kirkholt/freETarget/Documentation/Pictures/Illustrations/Pistol Assembly 1.png

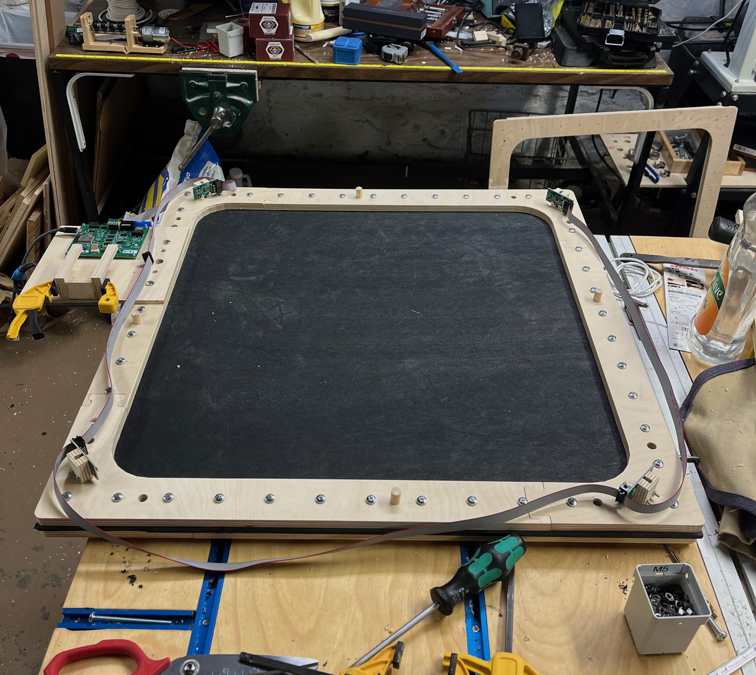
Documentation/Pictures/Illustrations/Pistol Assembly 1.png
