kirkholt/freETarget/Documentation/Pictures/Schematic.png

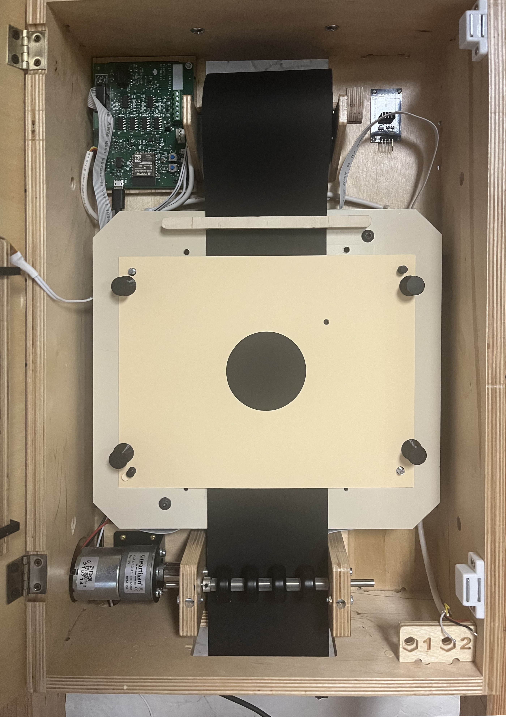
Documentation/Pictures/Schematic.png
