kirkholt/freETarget/Software/ESP32/test_scripts.txt

//
// WIFI Tests 
//
Static IP  { "WIFI_SSID": "googlefiber",  "WIFI_PWD": "kansas6108", "NAME_ID": 100, "NAME_TEXT":"ENGINEERING", "WIFI_IP":"192.168.86.109" }
Static IP  { "WIFI_SSID": "googlefiber",  "WIFI_PWD": "kansas6108", "NAME_ID": 100, "NAME_TEXT":"NEXUS", "WIFI_IP":"192.168.86.109" }
Static IP  { "WIFI_SSID": "googlefiber",  "WIFI_PWD": "kansas6108", "NAME_ID": 100, "NAME_TEXT":"62I", "WIFI_IP":"192.168.86.111" }
Static IP  { "WIFI_SSID": "COMET", "WIFI_IP":"192.168.0.103", "WIFI_GATEWAY":"192.168.0.1" }
Default IP { "WIFI_SSID": "", "WIFI_IP":"192.168.0.103", "WIFI_GATEWAY":"192.168.0.1" }
Dynamic IP { "WIFI_SSID": "googlefiber",  "WIFI_PWD": "kansas6108", "NAME_ID": 100, "NAME_TEXT":"ENGINEERING"}
{ "NAME_ID": 99, "NAME_TEXT":"ALLAN"}
{ "NAME_ID": 101}
HTTP Trace             {"TRACE":128}
Reset the target       {"RESET":0}
Reinitialize the board {"INIT":0}

{ "WIFI_SSID": "",  "WIFI_PWD": "", "NAME_ID": 4}

//
// Witness Paper Settings 
//
Practice witness paper { "PAPER_TIME":250, "PAPER_ECO":30, "PAPER_SHOT":4}
Practice witness paper { "PAPER_TIME":250, "PAPER_ECO":40, "PAPER_SHOT":2}
Practice witness paper { "PAPER_TIME":125, "PAPER_ECO":40, "PAPER_SHOT":4}

{ "AUTH_CODE":1234,  "AUTH_CODE":4321}
{ "AUTH_CODE":1234, "AUTH_CODE":0, "ECHO":0 }
{"WIFI_SSID":"FSixC! Box FE":, "WIFI_PWD":":1234512345123451234512345"}

Firmware debug trace   { "TRACE":16, "TRACE":32, "TRACE":64, "TEST":142}
Calculation debug trace {"TRACE": 2048, "TRACE":8, "TRACE":64}
Rapid Fire {"TRACE":2048}
Turn on RS488 {"AUX_MODE":8}

//
// Rapid Fire and Tabata 
//
Output for Rapid Fire  { "MFS_HOLD_C":18, "MFS_HOLD_D":20, "MFS_SELECT_CD":24}
LED control { "MFS_HOLD_C":18, "MFS_HOLD_D":20, "MFS_SELECT_CD":24}
ISSF 50m Rapid Fire       Five shots into a single target            {"TRACE":2048, "EVENT":"RFP Allan", "RAPID_COUNT":5,  "RAPID_TIME":8,   "RAPID_WAIT":5, "RAPID_ENABLE":0}
ISSF 50m Rapid Fire       Five shots into a single target            {"TRACE":2048,  "EVENT":"RFP Allan", "RAPID_COUNT": 1 , "RAPID_WAIT":3, "RAPID_TIME":8, "RAPID_ENABLE": 1 }
ISSF 50m Rapid Fire       No Trace                                   {"TRACE":2048, "EVENT":"RFP Allan", "RAPID_COUNT": 1 , "RAPID_WAIT":3, "RAPID_TIME":8, "RAPID_ENABLE": 1 }
ISSF 50m Rapid Fire       Five shots into a single target            {"TRACE":2048, "EVENT":"Rapid Fire 8S",      "RAPID_COUNT":5,  "RAPID_TIME":8,   "RAPID_WAIT":5, "RAPID_ENABLE":1}ISSF 25m Standard Pistol  Five shots into a single target           
 {"RAPID_REPEAT":5} 
 {"TRACE":2048, "EVENT":"Rapid Fire 30s",     "RAPID_COUNT":5,  "RAPID_TIME":30,  "RAPID_WAIT":5, "RAPID_ENABLE":1}
 
 {"TRACE":2048, "EVENT":"Rapid Fire 8S", "RAPID_COUNT":5, "RAPID_WAIT":7, "RAPID_TIME":50, "RAPID_ENABLE": 1 }

NRA Sport Pistol ON         One shot into a single target, repeat 5x {"TRACE":2048, "EVENT":"SPP Allan", "RAPID_COUNT":1,  "RAPID_TIME":3,   "RAPID_WAIT":7, "RAPID_ENABLE":1}
                                                                     {"TRACE":2120, "EVENT":"SPP Allan", "RAPID_COUNT":1,  "RAPID_TIME":3,   "RAPID_WAIT":7, "RAPID_ENABLE":1}
NRA Sport Pistol OFF        One shot into a single target, repeat 5x {"TRACE":2048, "EVENT":"SPP Betty", "RAPID_COUNT":1,  "RAPID_TIME":3,   "RAPID_WAIT":7, "RAPID_ENABLE":0}
NRA Sport Pistol ON         One shot into a single target, repeat 5x {"RAPID_COUNT":1,  "RAPID_TIME":3,   "RAPID_WAIT":7, "RAPID_ENABLE":1}

Tabata                      Tabata timing                            {"TRACE":2048, "EVENT":"Tabata",  "RAPID_COUNT": 1 , "RAPID_WAIT":3, "RAPID_TIME":7, "RAPID_ENABLE": 1 }
Done {"RAPID_ENABLE":0}

Turn Tabata on by switch   {"MFS_TAP_1":6}

//
// MFS Operation
//
PC Shot Test {"MFS_TAP_1":4 }
{"}
Start a download {"DOWNLOAD":1234567}
RS485 {"AUX_MODE":8}

{"ECHO":0}

//
// Calibration Tests 
//
Raw
{"CAL":1, "CAL":8, [-55.24, -61.51, 18.04, 78.51, -35.96, -43.34, -12.31, -35.85, 25.12, 40.27, -17.49, 32.01, -16.46, -29.50, 15.00, -65.67, -52.11, 22.98, -21.67, -16.85, 35.60, -41.26, 29.78, -24.88, 30.48, 91.39, -51.31, -0.62, -26.73, 21.00, -55.49, 10.10, 29.73, 14.96,  22.81, -23.55, -41.35, -7.55]}

Target Scan
{"CAL":2}
1
"1","1","7.7","-21.03","-15.66"
"2","1","6.9","-15.21","-28.20"
"3","1","6.5","-11.33","-33.89"
"4","1","6.4","-17.67","32.17"
"5","1","6.3","30.30","-21.61"
"6","1","4.9","23.84","42.26"
"7","1","4.3","36.51","-38.42"
"8","1","4.1","-34.60","-42.56"
"9","1","3.9","-51.80","22.48"
"10","1","3.0","16.47","-61.17"
"11","2","9.8","-0.24","-9.43"
"12","2","7.8","-8.49","-23.85"
"13","2","7.1","22.33","-20.86"
"14","2","6.8","28.63","17.05"
"15","2","6.6","-26.95","21.98"
"16","2","5.8","-41.04","-6.76"
"17","2","4.6","-50.76","0.22"
"18","2","3.9","-55.14","10.89"
"19","2","0.0","19.04","78.51"
"20","2","0.0","-56.24","-61.51"
!

Table Data
{"CAL":2}
2
-21.03, -15.66, -15.21, -28.20, -11.33, -33.89, -17.67, 32.17, 30.30, -21.61, 23.84, 42.26, 36.51, -38.42, -34.60, -42.56, -51.80, 22.48, 16.47, -61.17, -0.24, -9.43, -8.49, -23.85, 22.33, -20.86, 28.63, 17.05, -26.95, 21.98, -41.04, -6.76, -50.76, 0.22, -55.14, 10.89!

Commit Calibration {"CAL":3}

Show Calibration {"CAL":4}

void Calibration {"CAL":5}

ESPEFUSE

>ESPEFUSE adc_info --port COM3 --baud 115200
