kirkholt/freETarget/Documentation/Pictures/DC Motor Connection.png

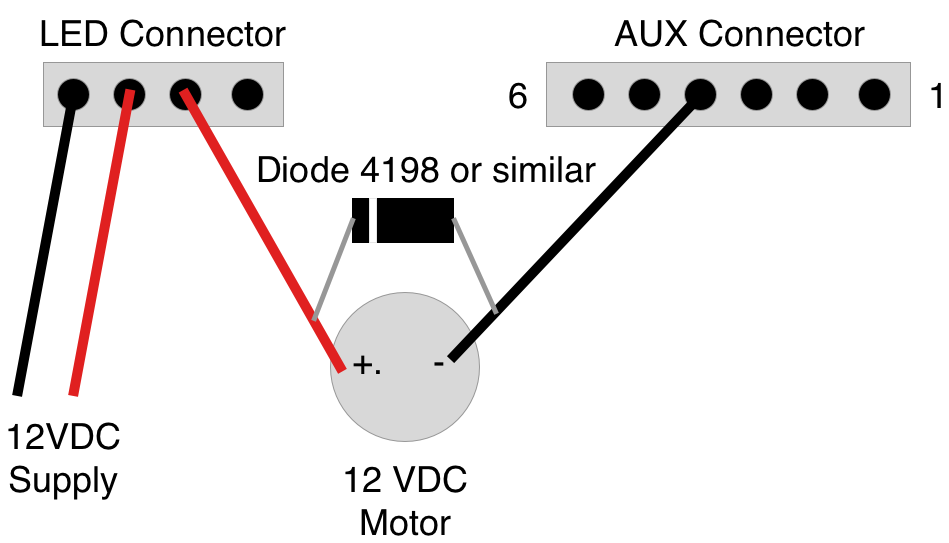
Documentation/Pictures/DC Motor Connection.png
