kirkholt/freETarget/Documentation/Pictures/Illustrations/50m Target Section.png

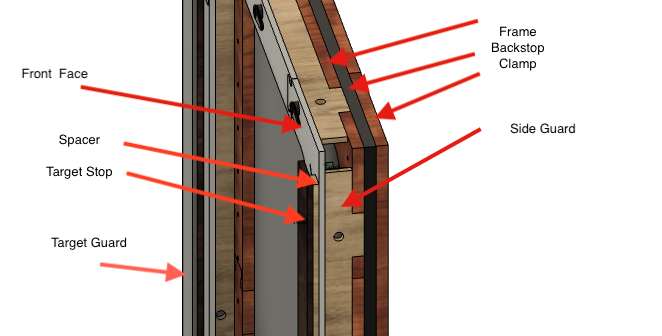
Documentation/Pictures/Illustrations/50m Target Section.png
