kirkholt/freETarget/Documentation/Pictures/Illustrations/Application Configuration.png

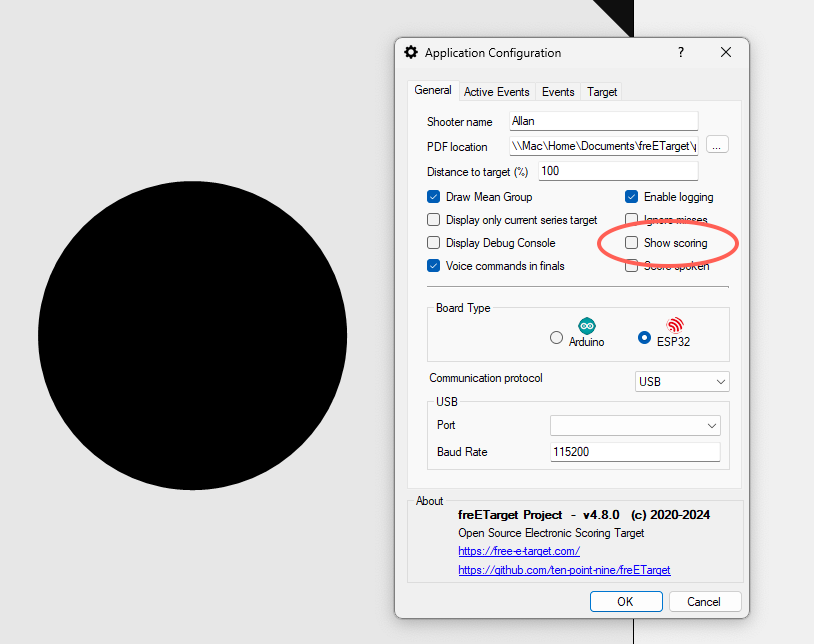
Documentation/Pictures/Illustrations/Application Configuration.png
