kirkholt/freETarget/Documentation/Pictures/Illustrations/Ethernet Cable V5 Harness.png

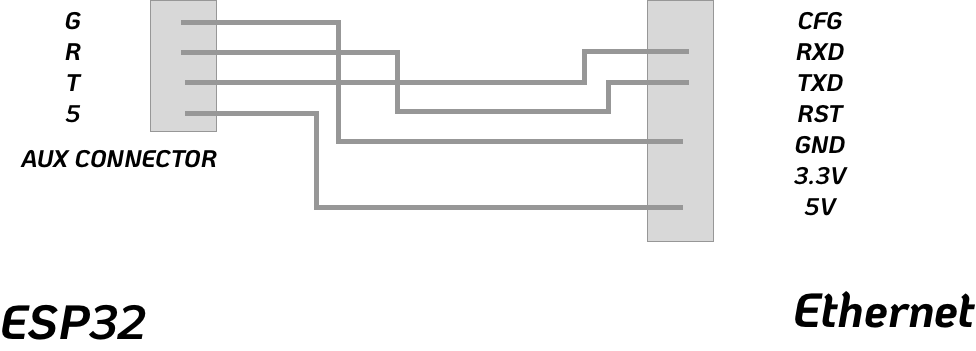
Documentation/Pictures/Illustrations/Ethernet Cable V5 Harness.png
