kirkholt/freETarget/Documentation/Pictures/Illustrations/Flat Cable.png

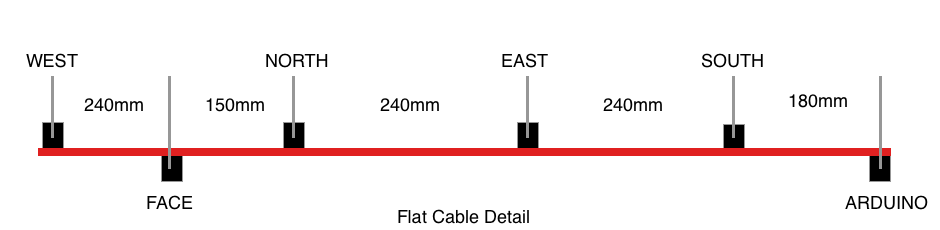
Documentation/Pictures/Illustrations/Flat Cable.png
