kirkholt/freETarget/Documentation/Pictures/Illustrations/freETarget Layout.png

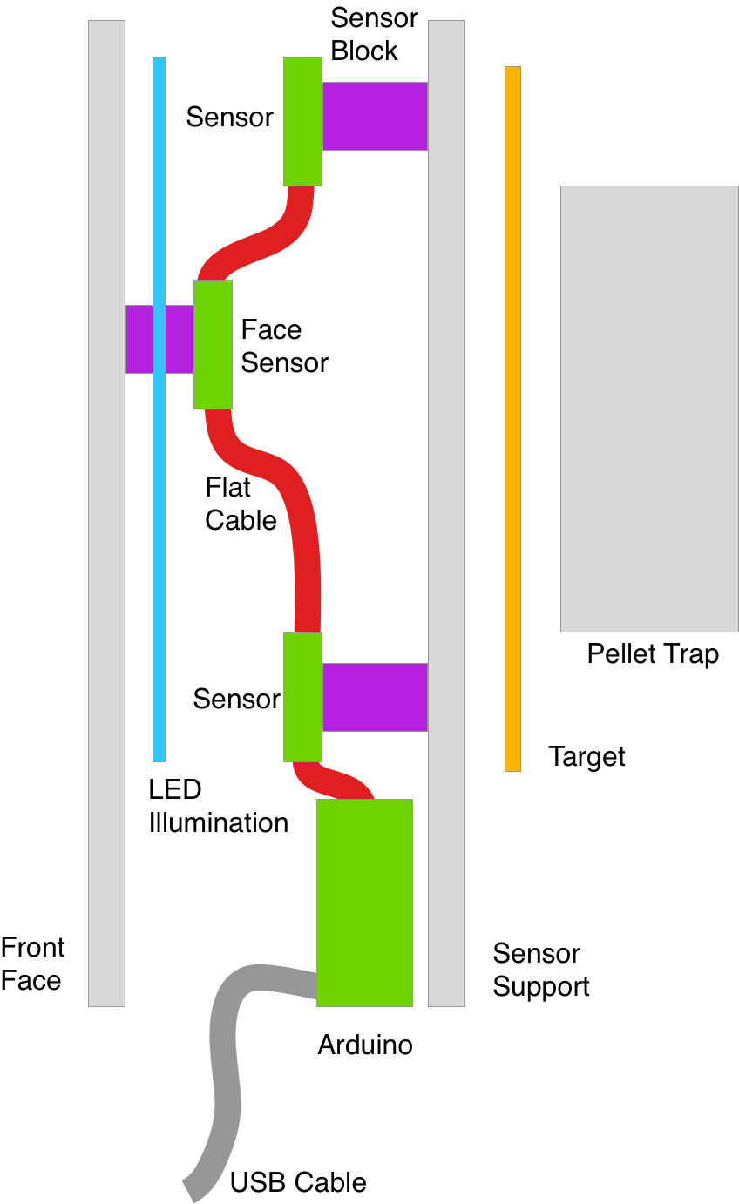
Documentation/Pictures/Illustrations/freETarget Layout.png
