kirkholt/freETarget/Documentation/Pictures/Illustrations/Front View.png

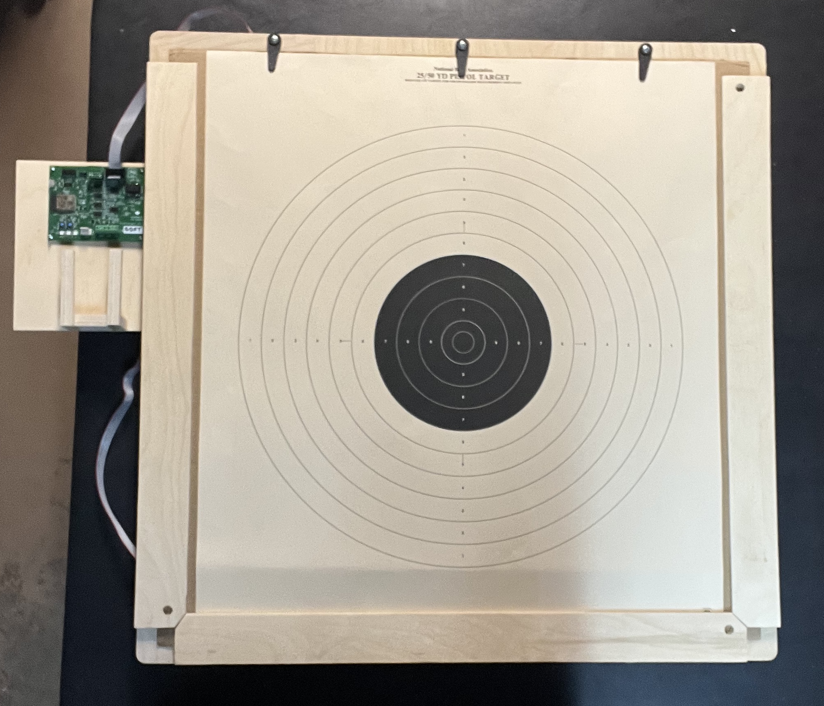
Documentation/Pictures/Illustrations/Front View.png
