kirkholt/freETarget/Documentation/Pictures/Illustrations/LiveTarget.png

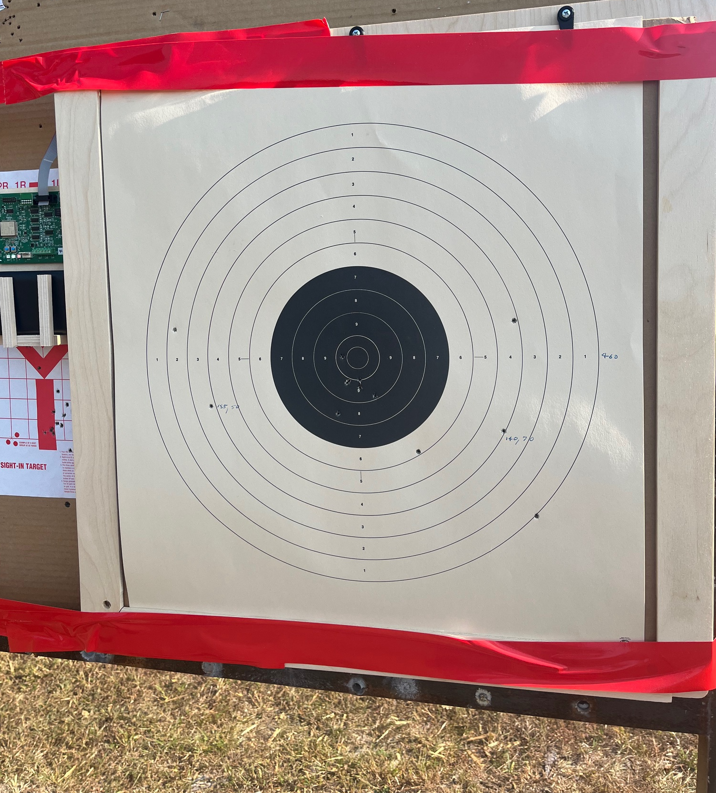
Documentation/Pictures/Illustrations/LiveTarget.png
