kirkholt/freETarget/Documentation/Pictures/Illustrations/PC Client.png

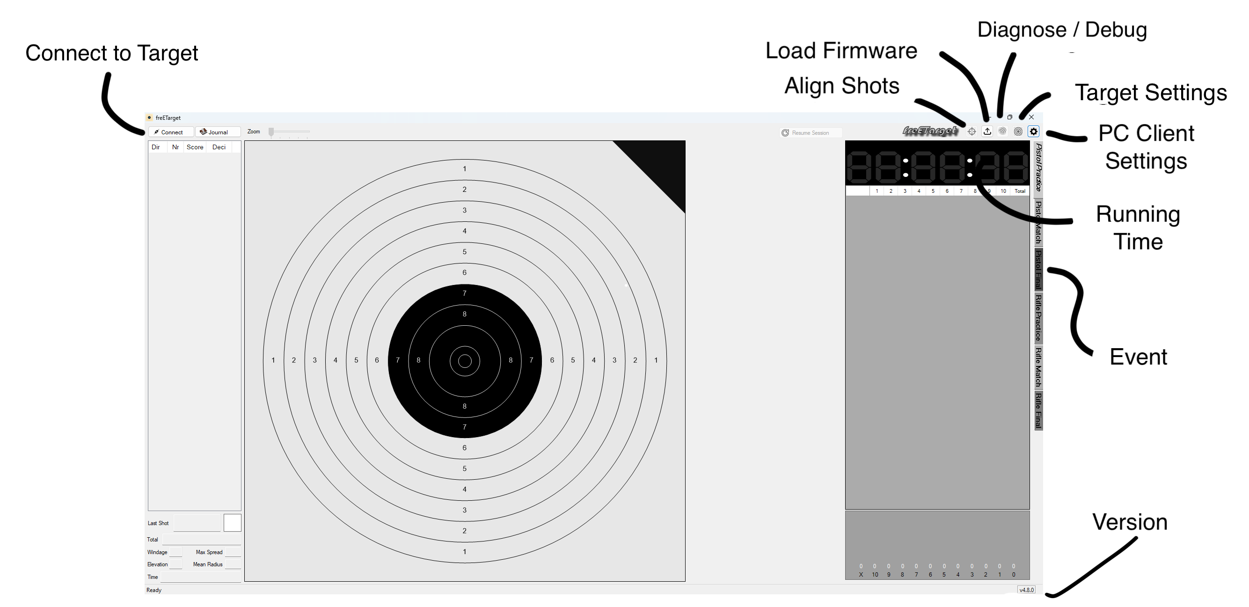
Documentation/Pictures/Illustrations/PC Client.png
