kirkholt/freETarget/Documentation/Pictures/Illustrations/Shelves.png

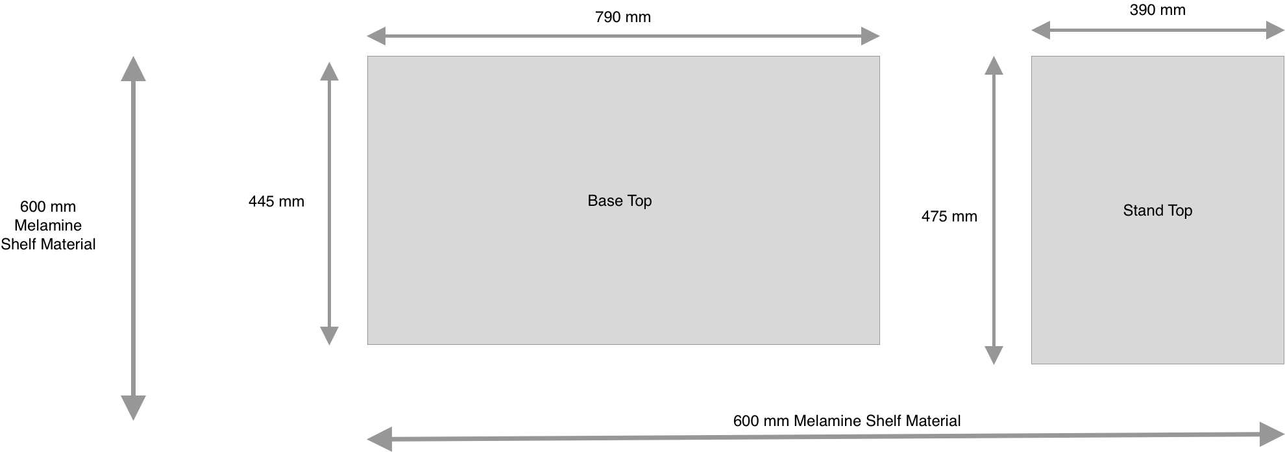
Documentation/Pictures/Illustrations/Shelves.png
