kirkholt/freETarget/Documentation/Pictures/Illustrations/USB Extender.png

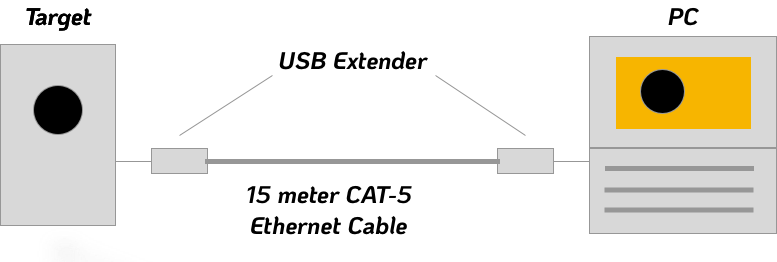
Documentation/Pictures/Illustrations/USB Extender.png
