kirkholt/freETarget/Documentation/Pictures/scope traces/SDS00013.bmp

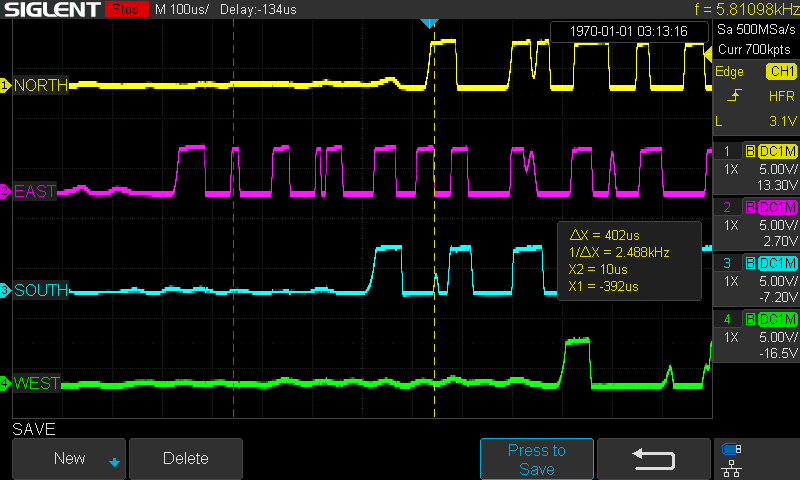
Documentation/Pictures/scope traces/SDS00013.bmp
