kirkholt/freETarget/Documentation/Pictures/scope traces/SDS00014.bmp

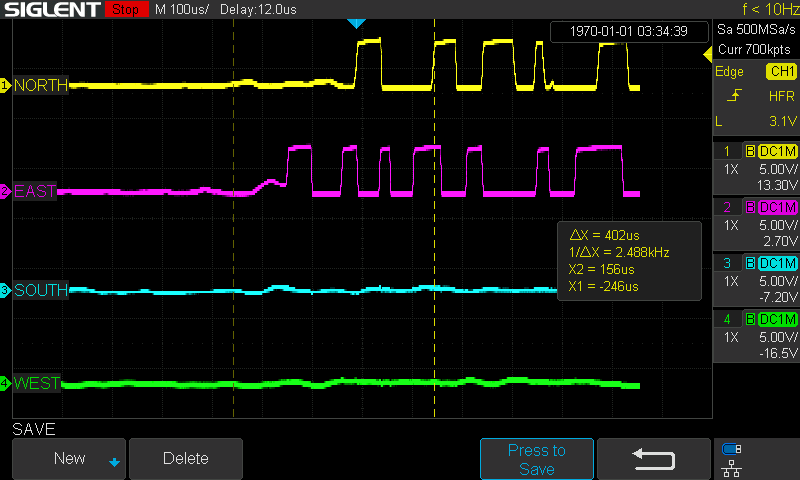
Documentation/Pictures/scope traces/SDS00014.bmp
