kirkholt/freETarget/Documentation/Pictures/scope traces/SDS00016.bmp

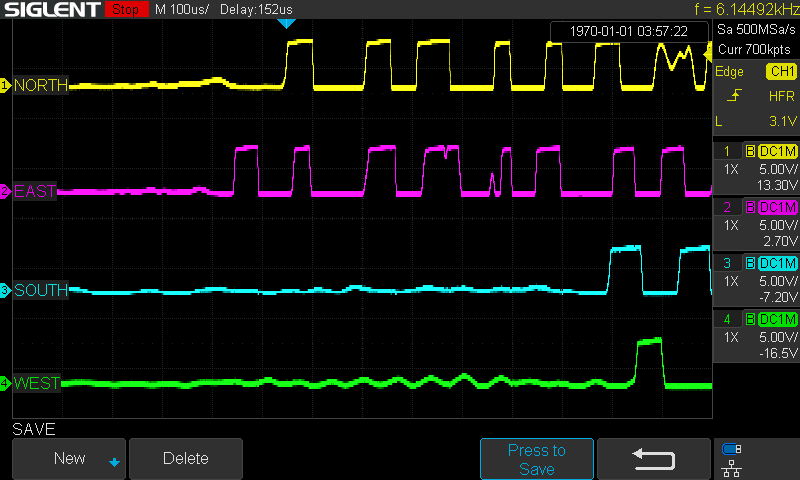
Documentation/Pictures/scope traces/SDS00016.bmp
