kirkholt/freETarget/Mechanical/CNC/Metal - Plastic/Witness Paper Complete.stl

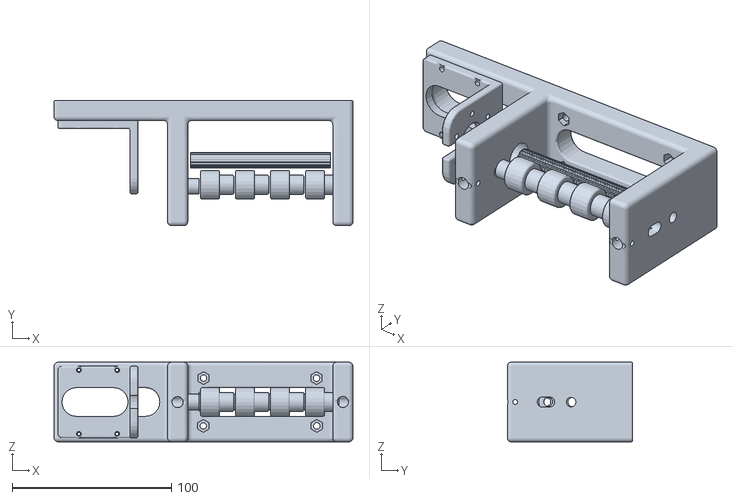
[picture p58: CAD file, 2026-10-04]
Mechanical/CNC/Metal - Plastic/Witness Paper Complete.stl
187.7 x 78.7 x 50.0
