kirkholt/freETarget/Mechanical/CNC/50m Pistol/50m Pistol.stl

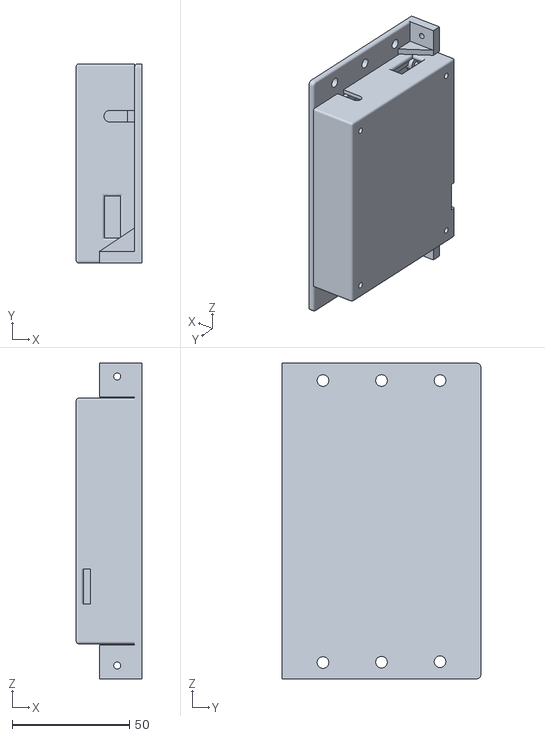
[picture p59: CAD file, 2026-10-04]
Mechanical/CNC/50m Pistol/50m Pistol.stl
28.0 x 85.0 x 135.0
