kirkholt/freETarget/Mechanical/CNC/Metal - Plastic/Magnetic Rifle Target.stl

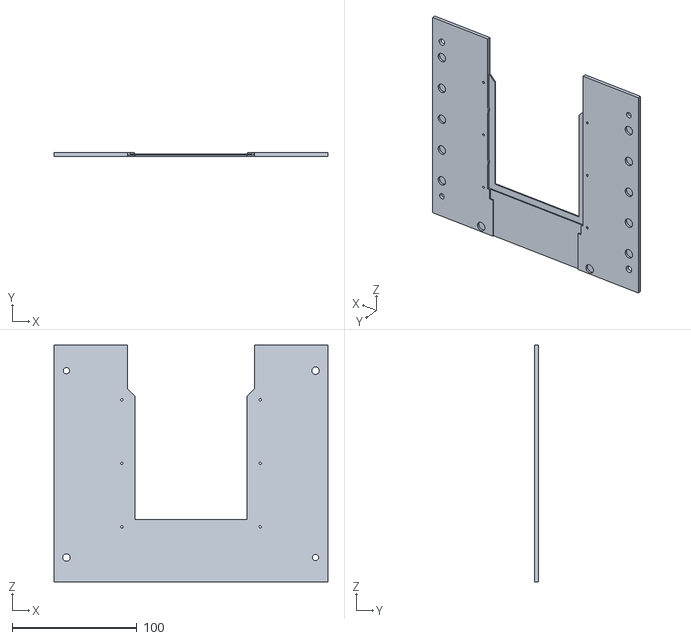
[picture p60: CAD file, 2026-10-04]
Mechanical/CNC/Metal - Plastic/Magnetic Rifle Target.stl
220.0 x 3.00 x 190.0
