kirkholt/freETarget/Mechanical/CNC/Piece Parts/Cable Guide/Laser Cable Guide.dxf

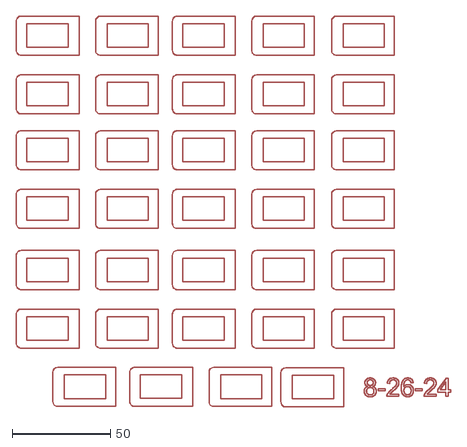
[picture p61: CAD file, 2026-10-04]
Mechanical/CNC/Piece Parts/Cable Guide/Laser Cable Guide.dxf
221.5 x 199.3
