kirkholt/freETarget/Mechanical/CNC/Piece Parts/Pellet Trap Guide.3mf

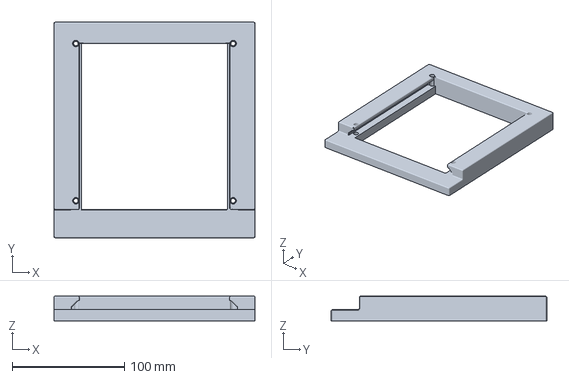
[picture p62: CAD file, 2026-10-04]
Mechanical/CNC/Piece Parts/Pellet Trap Guide.3mf
179.0 x 192.0 x 22.0 mm
