kirkholt/freETarget/Mechanical/CNC/Traffic Lights/Roll.stl

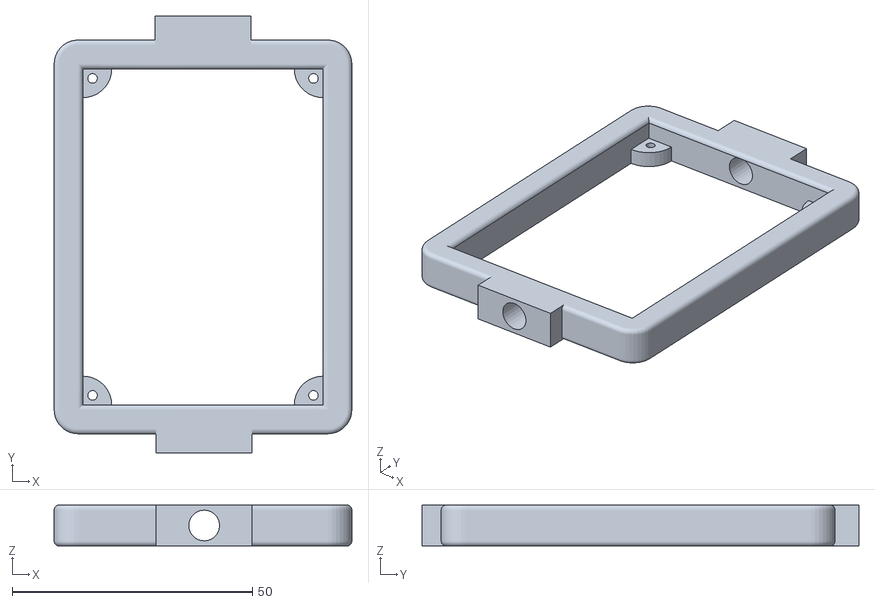
[picture p63: CAD file, 2026-10-04]
Mechanical/CNC/Traffic Lights/Roll.stl
62.0 x 91.0 x 8.50
