kirkholt/freETarget/Mechanical/CNC/Metal - Plastic/Pellet Holder.stl

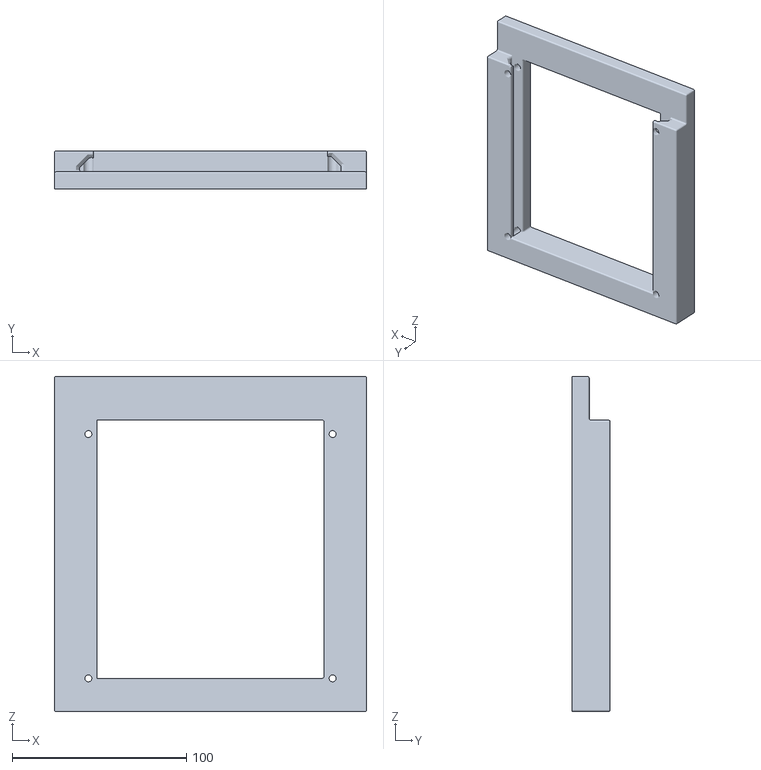
[picture p65: CAD file, 2026-10-04]
Mechanical/CNC/Metal - Plastic/Pellet Holder.stl
179.0 x 22.0 x 192.0
