kirkholt/freETarget/Mechanical/CNC/50m Pistol/corner.stl

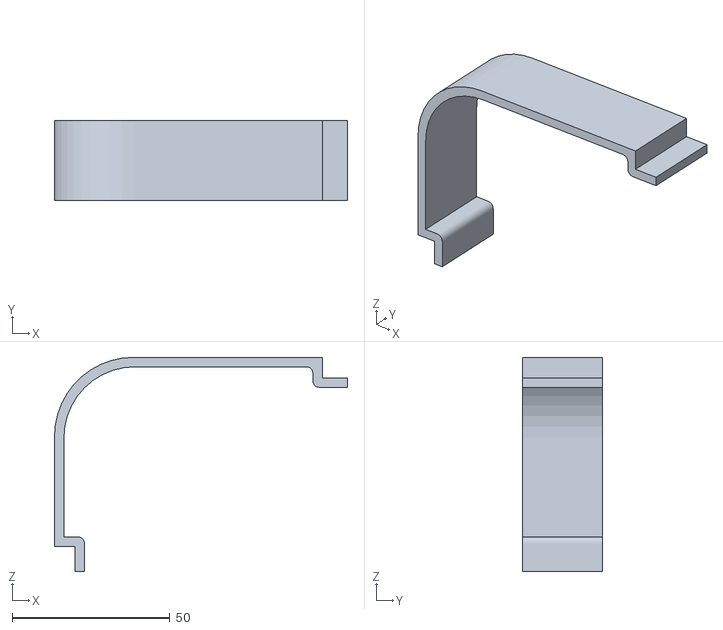
[picture p67: CAD file, 2026-10-04]
Mechanical/CNC/50m Pistol/corner.stl
93.0 x 25.5 x 68.0
