kirkholt/freETarget/Mechanical/CNC/Traffic Lights/Traffic Lights_1.stl

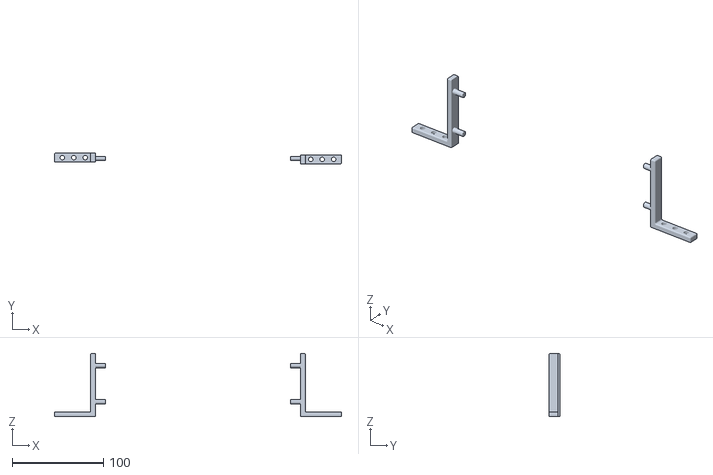
[picture p68: CAD file, 2026-10-04]
Mechanical/CNC/Traffic Lights/Traffic Lights_1.stl
314.3 x 12.0 x 69.0
