kirkholt/freETarget/Mechanical/CNC/50m Pistol/PCB Case.stl

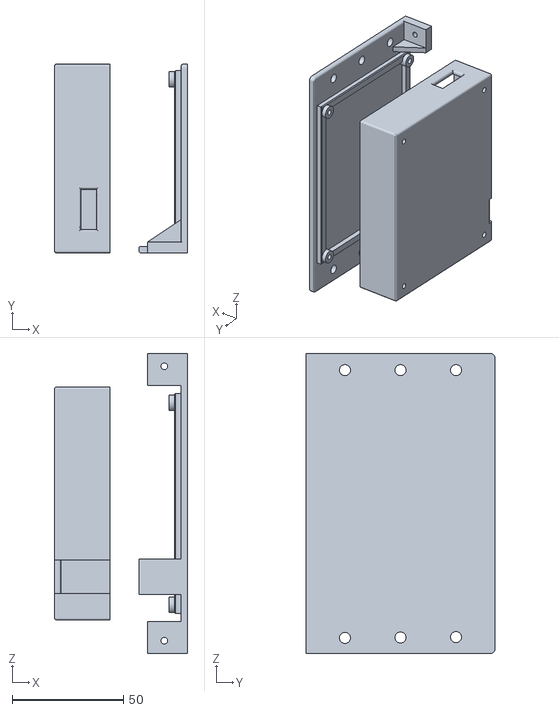
[picture p69: CAD file, 2026-10-04]
Mechanical/CNC/50m Pistol/PCB Case.stl
60.0 x 85.0 x 135.0
