kirkholt/freETarget/Mechanical/CNC/Metal - Plastic/Ethernet Housing 2.stl

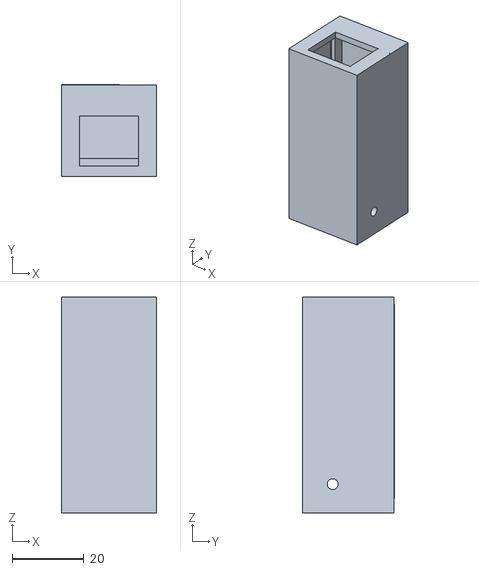
[picture p70: CAD file, 2026-10-04]
Mechanical/CNC/Metal - Plastic/Ethernet Housing 2.stl
26.5 x 25.6 x 60.0
