kirkholt/freETarget/Mechanical/CNC/Traffic Lights/Back Cover.stl

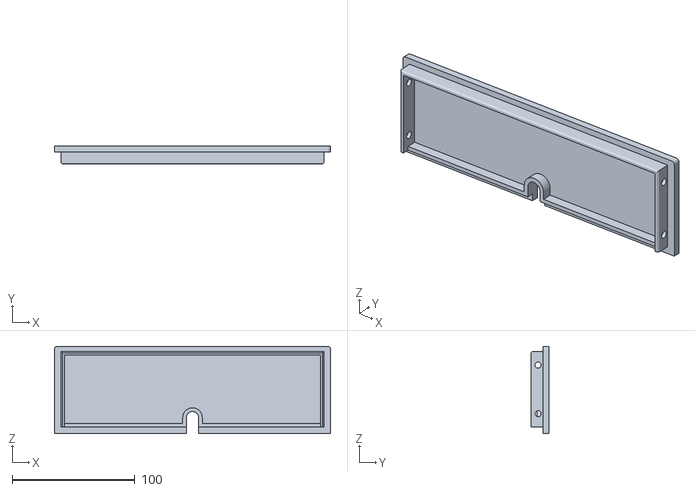
[picture p71: CAD file, 2026-10-04]
Mechanical/CNC/Traffic Lights/Back Cover.stl
225.0 x 15.0 x 71.0
