kirkholt/freETarget/Mechanical/CNC/Metal - Plastic/Magnetic Pistol Holder.stl

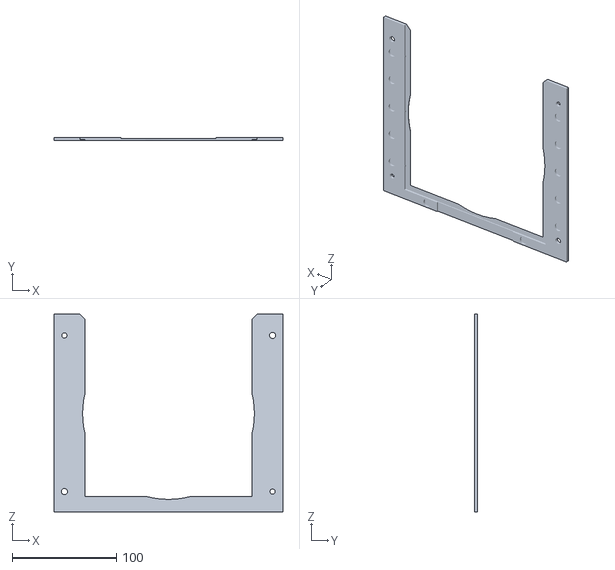
[picture p73: CAD file, 2026-10-04]
Mechanical/CNC/Metal - Plastic/Magnetic Pistol Holder.stl
220.0 x 3.00 x 190.0
