kirkholt/freETarget/Mechanical/CNC/Traffic Lights/Mounts.stl

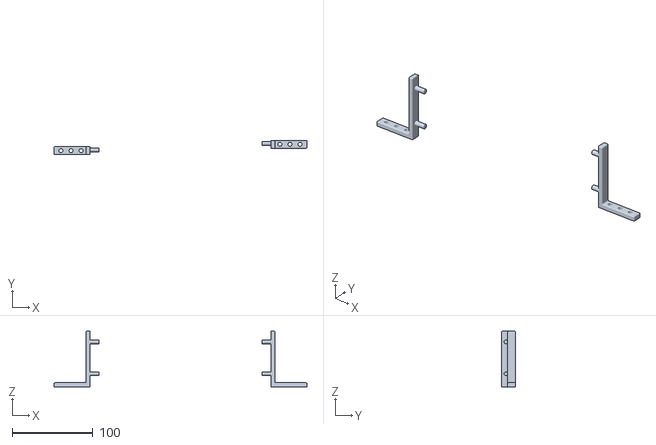
[picture p74: CAD file, 2026-10-04]
Mechanical/CNC/Traffic Lights/Mounts.stl
314.3 x 18.0 x 69.0
