kirkholt/freETarget/Mechanical/CNC/50m Pistol/Cable Clamp.stl

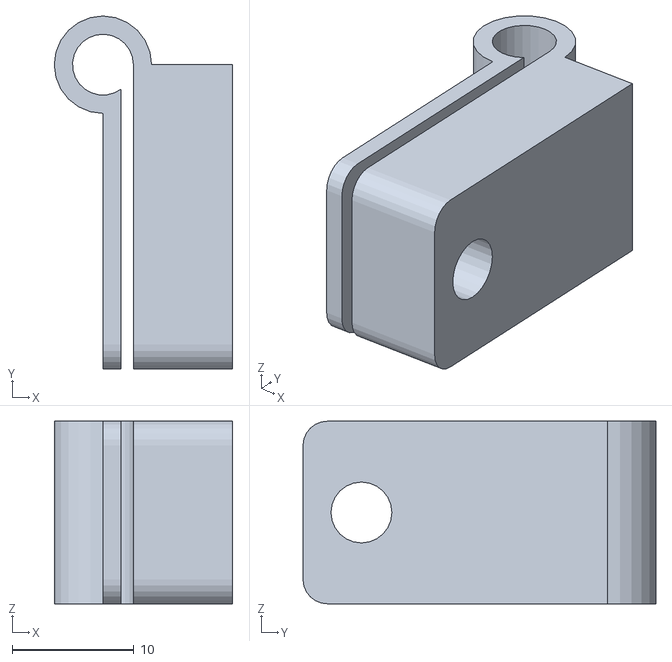
[picture p75: CAD file, 2026-10-04]
Mechanical/CNC/50m Pistol/Cable Clamp.stl
14.7 x 29.0 x 15.0
