kirkholt/freETarget/Mechanical/CNC/Metal - Plastic/Ethernet Housing.stl

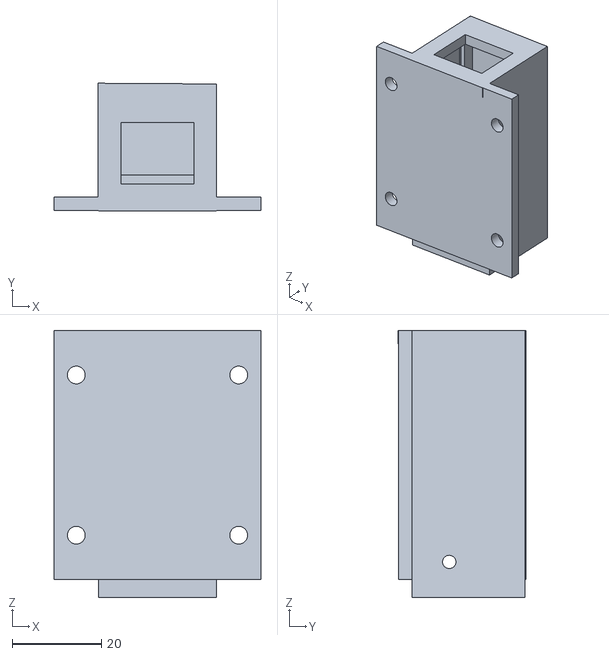
[picture p76: CAD file, 2026-10-04]
Mechanical/CNC/Metal - Plastic/Ethernet Housing.stl
46.5 x 28.7 x 60.0
