kirkholt/freETarget/Mechanical/CNC/Metal - Plastic/Pistol Target.3mf

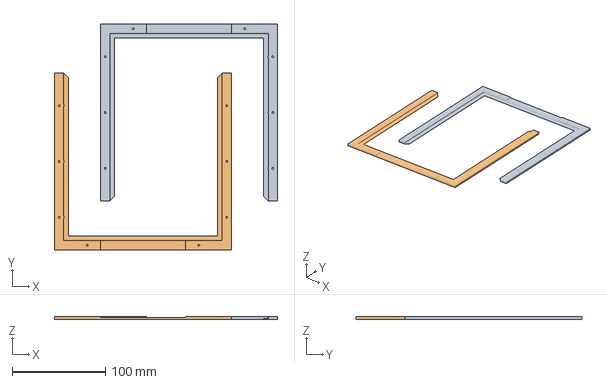
[picture p77: CAD file, 2026-10-04]
Mechanical/CNC/Metal - Plastic/Pistol Target.3mf
239.5 x 242.5 x 3.00 mm
Pistol Target.stl x 2
