kirkholt/freETarget/Mechanical/CNC/Metal - Plastic/Face Sensor Spacer.stl

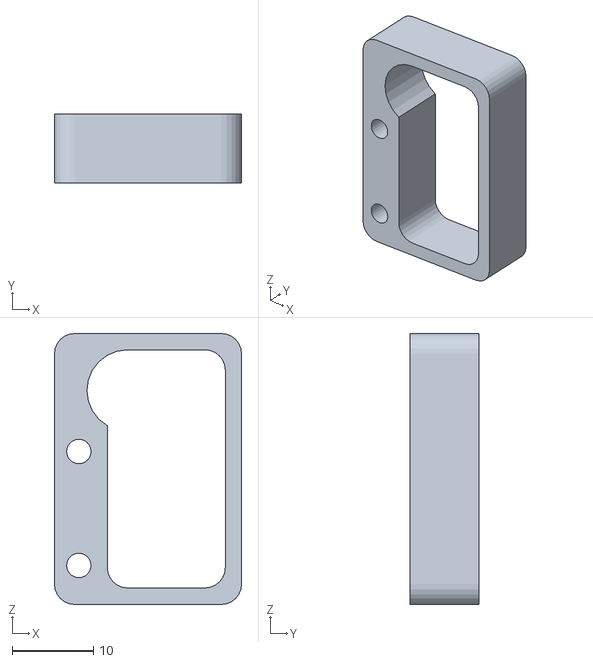
[picture p78: CAD file, 2026-10-04]
Mechanical/CNC/Metal - Plastic/Face Sensor Spacer.stl
23.0 x 8.50 x 33.3
