kirkholt/freETarget/Mechanical/CNC/Metal - Plastic/Cable Clamp.stl

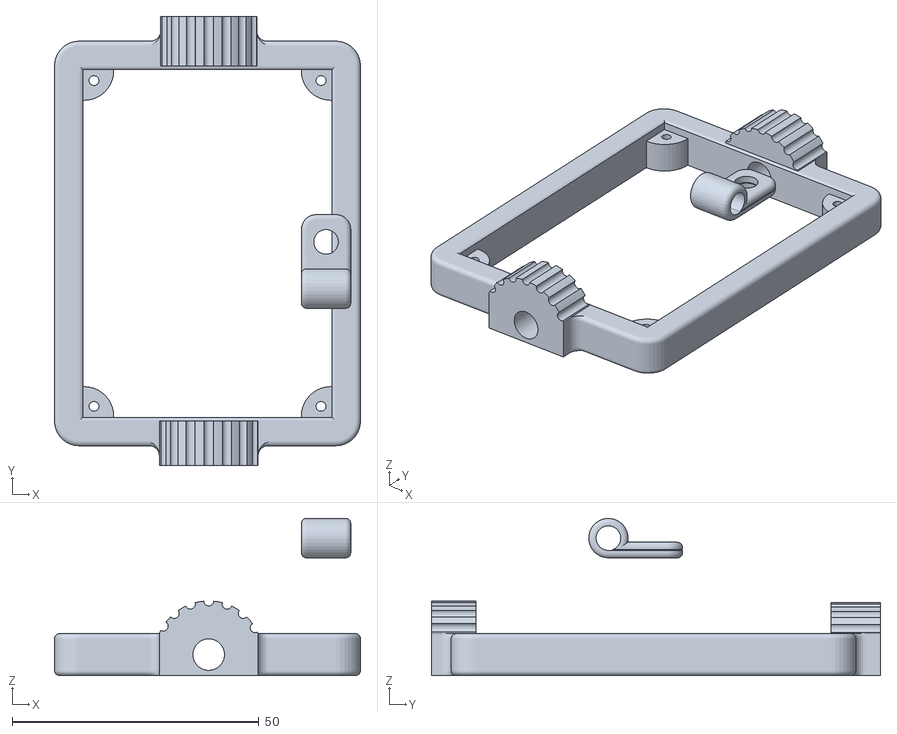
[picture p79: CAD file, 2026-10-04]
Mechanical/CNC/Metal - Plastic/Cable Clamp.stl
62.0 x 91.0 x 31.8
