kirkholt/freETarget/Mechanical/CNC/Metal - Plastic/clamp.stl

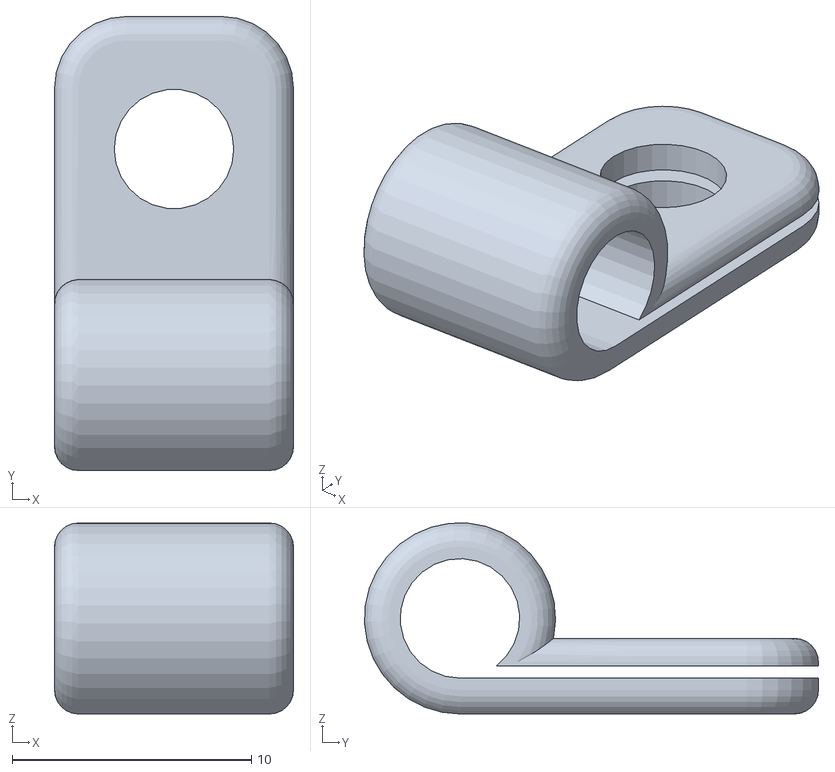
[picture p80: CAD file, 2026-10-04]
Mechanical/CNC/Metal - Plastic/clamp.stl
10.0 x 19.0 x 7.99
