kirkholt/freETarget/Mechanical/CNC/Metal - Plastic/Arcade Target.stl

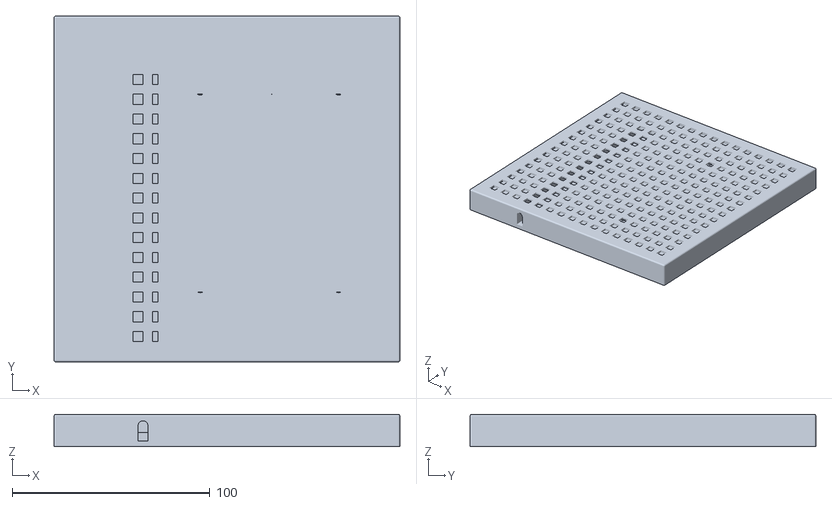
[picture p81: CAD file, 2026-10-04]
Mechanical/CNC/Metal - Plastic/Arcade Target.stl
175.0 x 175.0 x 16.4
