kirkholt/freETarget/Mechanical/CNC/Metal - Plastic/Witness Paper Spacer.stl

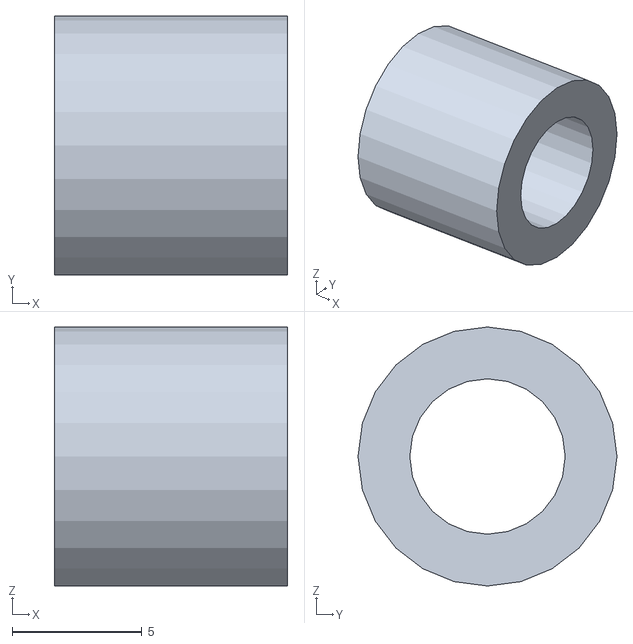
[picture p82: CAD file, 2026-10-04]
Mechanical/CNC/Metal - Plastic/Witness Paper Spacer.stl
9.00 x 10.0 x 10.0
