kirkholt/freETarget/Mechanical/CNC/Metal - Plastic/Traffic Lights Case.stl

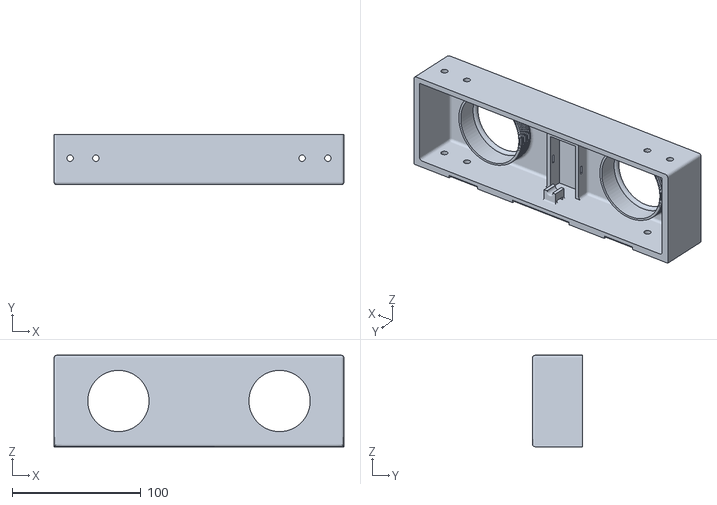
[picture p83: CAD file, 2026-01-06]
Mechanical/CNC/Metal - Plastic/Traffic Lights Case.stl
225.0 x 39.0 x 71.0
