kirkholt/freETarget/Mechanical/CNC/Metal - Plastic/ISSF 50m Rifle Target Cover.stl

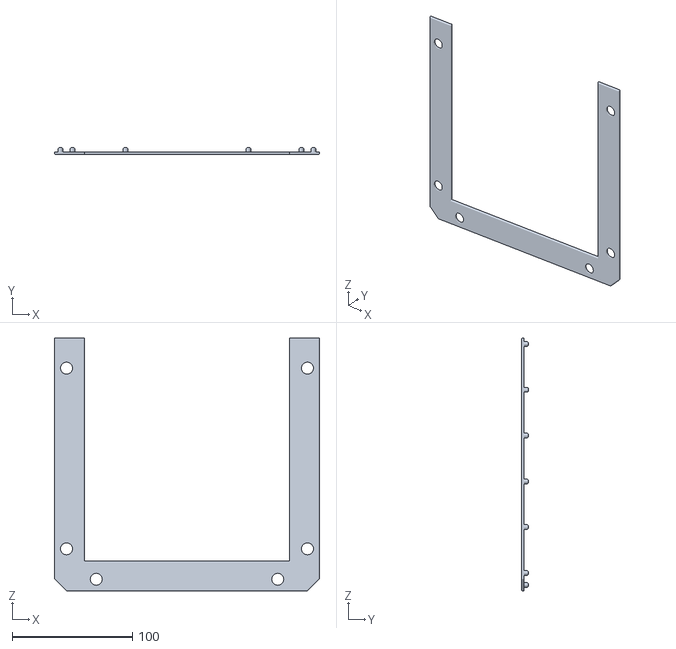
[picture p84: CAD file, 2026-01-06]
Mechanical/CNC/Metal - Plastic/ISSF 50m Rifle Target Cover.stl
220.0 x 6.00 x 210.0
