kirkholt/freETarget/Mechanical/CNC/Metal - Plastic/Cover Sprue.stl

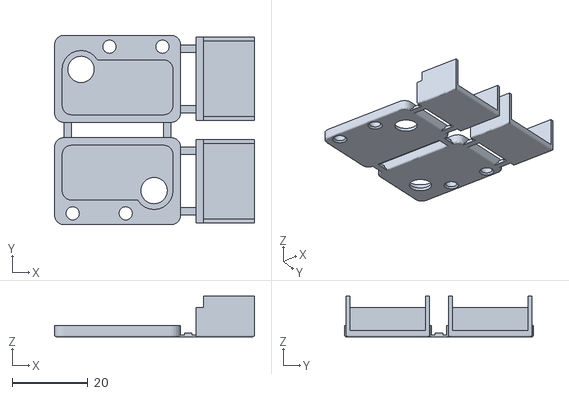
[picture p85: CAD file, 2026-01-06]
Mechanical/CNC/Metal - Plastic/Cover Sprue.stl
52.8 x 50.0 x 10.7
