kirkholt/freETarget/Mechanical/CNC/Metal - Plastic/Pistol Test Holder.stl

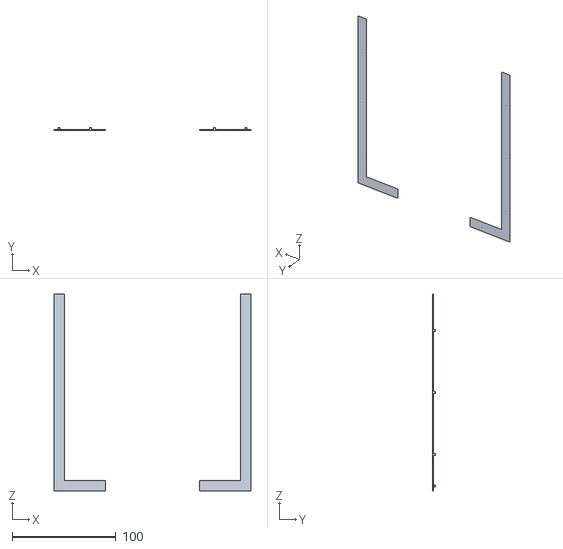
[picture p86: CAD file, 2026-01-06]
Mechanical/CNC/Metal - Plastic/Pistol Test Holder.stl
190.0 x 3.00 x 190.0
