kirkholt/freETarget/Mechanical/CNC/Metal - Plastic/Traffic Lights Lock Ring.stl

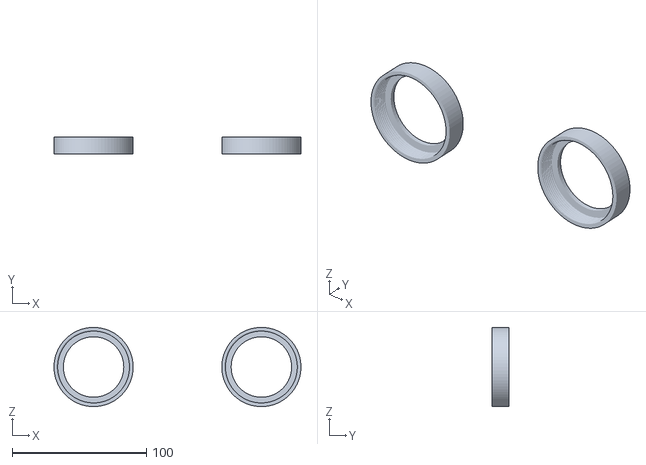
[picture p87: CAD file, 2026-01-06]
Mechanical/CNC/Metal - Plastic/Traffic Lights Lock Ring.stl
184.0 x 13.0 x 59.0
