kirkholt/freETarget/Mechanical/CNC/Metal - Plastic/Cable Tie.stl

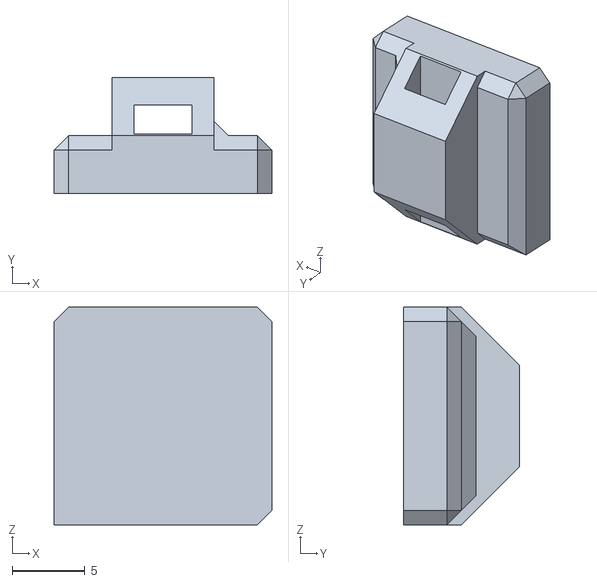
[picture p88: CAD file, 2026-01-06]
Mechanical/CNC/Metal - Plastic/Cable Tie.stl
15.0 x 8.00 x 15.0
