kirkholt/freETarget/Mechanical/CNC/Metal - Plastic/Traffic Lights Back Cover.stl

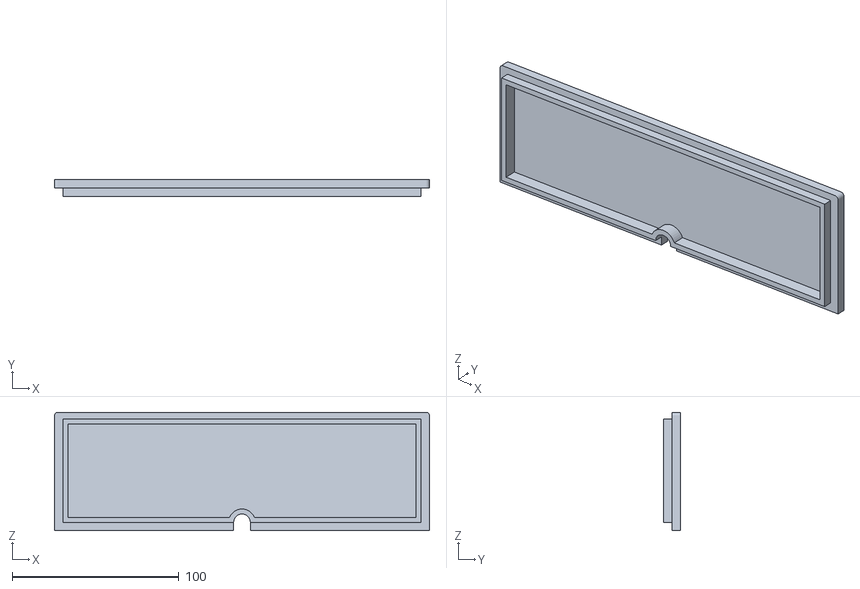
[picture p89: CAD file, 2026-01-06]
Mechanical/CNC/Metal - Plastic/Traffic Lights Back Cover.stl
225.0 x 10.0 x 71.0
