kirkholt/freETarget/Mechanical/CNC/Metal - Plastic/PCB Base.stl

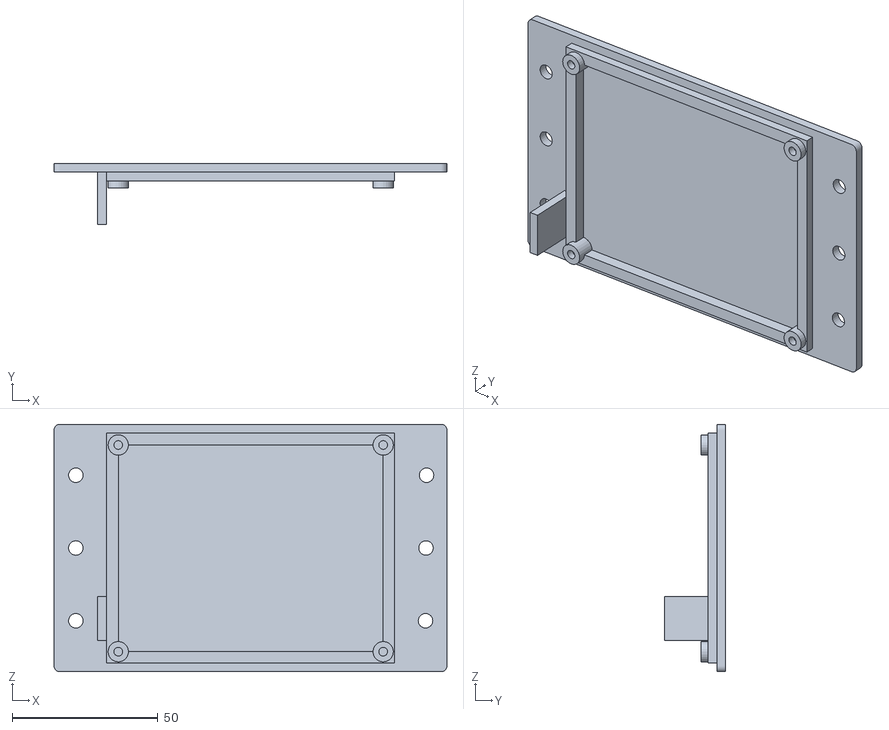
[picture p90: CAD file, 2025-08-27]
Mechanical/CNC/Metal - Plastic/PCB Base.stl
135.0 x 21.0 x 85.0
