kirkholt/freETarget/Mechanical/CNC/Metal - Plastic/50m Corners 2.stl

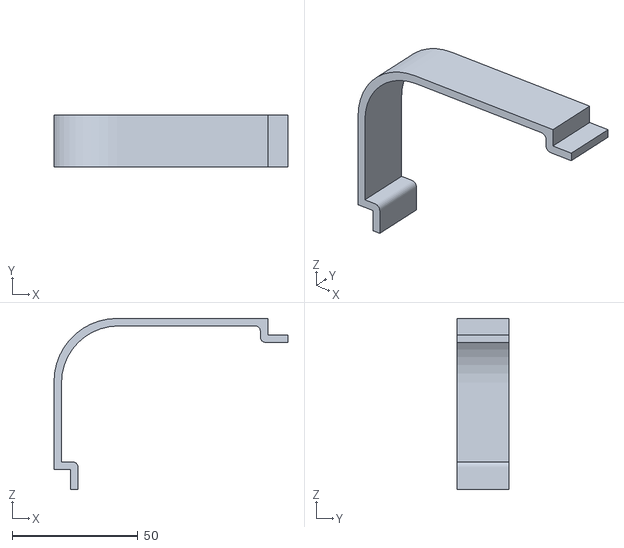
[picture p91: CAD file, 2025-08-27]
Mechanical/CNC/Metal - Plastic/50m Corners 2.stl
93.0 x 20.5 x 68.0
