kirkholt/freETarget/(list of files, cad)

Other CAD files:
Mechanical/CNC/Metal - Plastic/Cover Spure 26.3mf
Mechanical/CNC/50m Pistol/Plastic Parts x 2.3mf
Mechanical/CNC/50m Pistol/PCB Cover.stl_1.cxprj.3mf
Mechanical/CNC/50m Pistol/50m Pistol PCB Case 2.iges
Mechanical/CNC/50m Pistol/50m Pistol PCB Case.iges
Mechanical/CNC/50m Pistol/Plastic Parts.3mf
Mechanical/CNC/Metal - Plastic/Magnetic Rifle Holder.stl
Mechanical/CNC/Metal - Plastic/Cable Ties.3mf
Mechanical/CNC/Metal - Plastic/Traffic Lights v6.stl
Mechanical/CNC/Metal - Plastic/Test Pistol Holder.stl
Mechanical/CNC/Metal - Plastic/ISSF 50m Rifle Target Holder.3mf
Mechanical/CNC/Metal - Plastic/50m Pistol Corners.3mf
Mechanical/CNC/Metal - Plastic/Suis Pegs 2.3mf
Mechanical/CNC/Metal - Plastic/Suis Pegs.3mf
Mechanical/CNC/Metal - Plastic/ISSF 50m Rifle Target Holder.stl
Mechanical/CNC/Metal - Plastic/Mount.f3d
Mechanical/CNC/Piece Parts/Pellet Trap Guide.stl
Mechanical/CNC/Traffic Lights/Traffic Lights.stl
