kirkholt/freETarget/Documentation/Construction_and_Assembly/Assembling freETarget Club .docx

# freETarget

Application Note: Assembling freETarget Club

CAUTION

The flatpack is made from unfinished wood.

- Wear eye protection
- Use caution when assembling to avoid splinters

When using freeTarget:

- Wear eye protection
- Maintain a safe distance
- Do not shoot into any areas except the open target areas.

The freeETarget project or contributors will not be responsible for any injuries when using this target of it’s components.

Target shooting can be dangerous so apply caution in everything you do.

SUMMARY

This document provides the instructions for assembling the freeETarget Club target

REQUIRED

- Flatpack
- Wood Glue
- Hand tools
  - 2mm Allen key
  - 3mm Allen key
  - Small flat head screwdriver
  - Small Philips screw driver
  - Pliers or nut driver

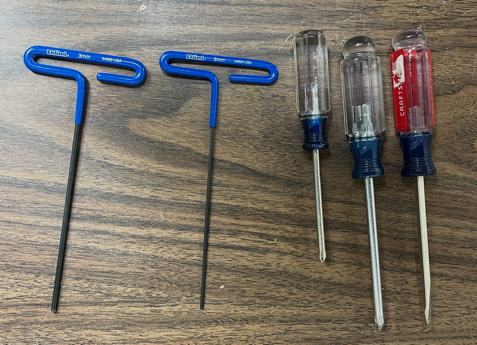
[picture p106: figure]

- Patience

INTRODUCTION

freETarget is an open source project to provide shooters with a low cost electronic target. To simplify the construction, the FreeETarget Flatpack was created to provide a single location for the mechanical construction.

The latest CAD files can be found at Github.com/ten-point-nine/freeetarget in the mechanical/cnc folder.

These instructions are for assemblies made after November 2022. Prior to that the screw assembly was not available and needed to be assembled with glue.

Assembling the flatpack is in three parts

- Assembling the back panel
- Assembling the target plate
- Target assembly

PACKING SLIP

Item | Description | Quantity
| Frame
1 | Back with sensor mounts and face plate bolts installed | 1
2 | Witness paper mounts | 2
| Optional Assembled Parts
3 | Witness paper drive with (qty) 4mm x 12 bolts | 1
4 | Multifunction switches | 1
5 | WiFi cable | 1
| Target Face
6 | General purpose target face | 1
7 | General purpose target guides | 1
8 | 5mm mounting screws | 4
9 | Witness paper guide | 1
| Piece Parts
10 | Sensor mounting bolts 3mm x 18 | 8
11 | Nuts 3 mm | 8
12 | WiFi mounting screws #2x1/4” | 4
13 | 3/8 x 4 wood screws | 8
14 | Wire ties | 10
15 | Witness paper dowel | 1

Assembling the Back Panel

Note, photos show similar Club Target back panel

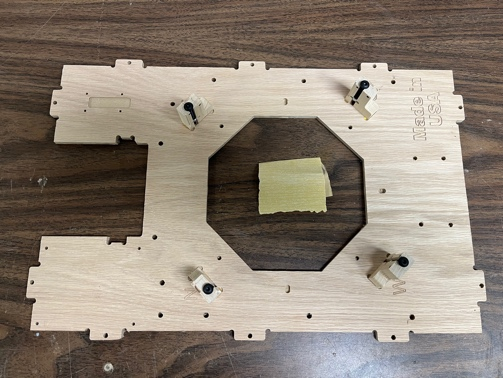
[picture p107: figure]

1 | Back Panel with Sensor Mounts

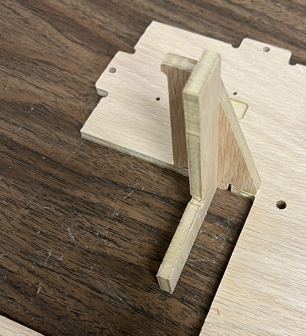
[picture p108: figure]

2 | Install the witness paper mounts, 2x using the wood glue

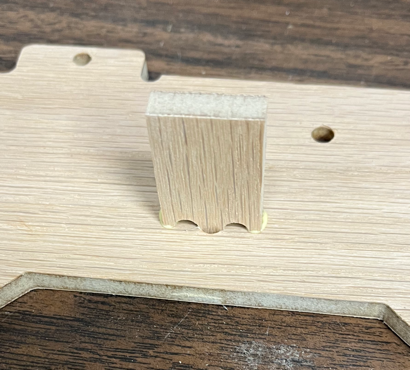
[picture p109: figure]

3 | Install the cable guides to the back panel

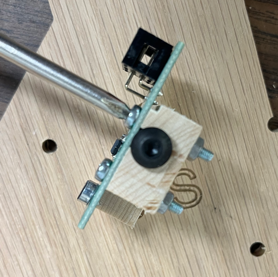
[picture p110: figure]

4 | Install the four sensors to the sensor mounts. Make sure that the sensors (ex North) match the mount (ex N)

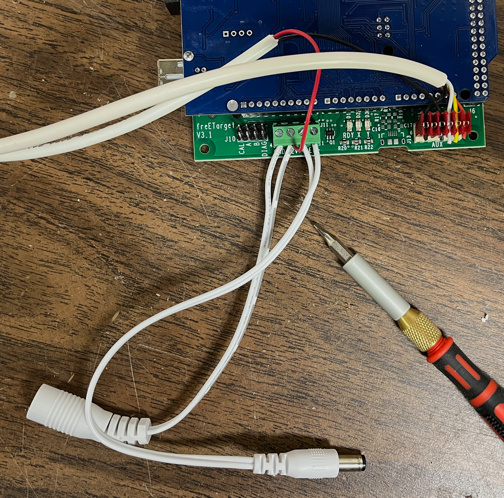
[picture p111: figure]

5 | | Install the connectors as shown in the photo WiFi wiring harness to AUX connector 12V LED ground to the GND terminal 12V LED + supply to the +12 terminal Motor RED conductor to the +12 termainl Positive LED lead to the LED+ Negative LED lead to the LED-

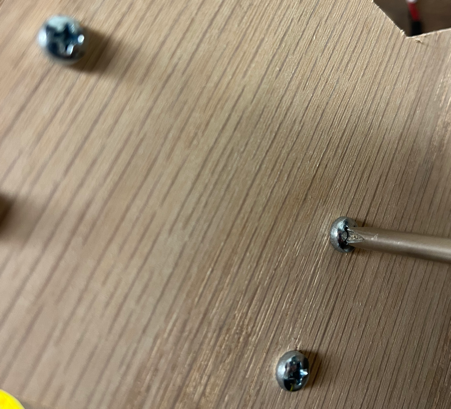
[picture p112: figure]

6 | If using witness paper, Install the witness paper drive using the 4mmx12 screws.

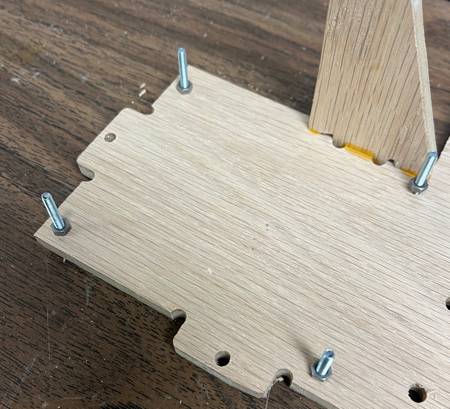
[picture p113: figure]

7 | Install the Arduino 3mmx25 mounting screws. Hold in place with nuts. Do not tighten completely

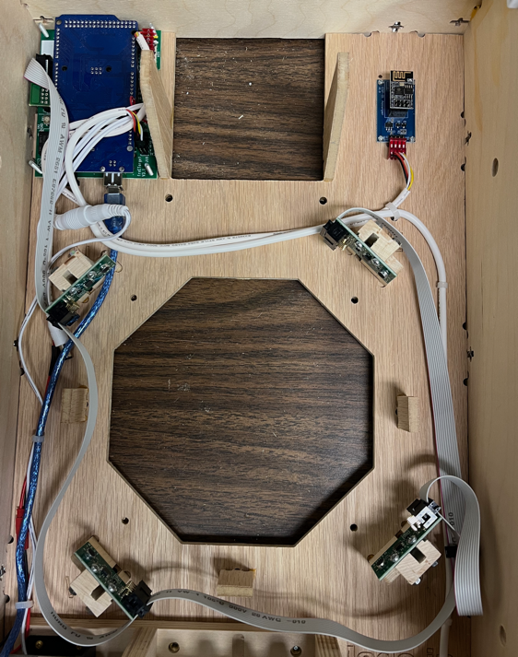
[picture p114: figure]

8 | | Install the flat cable from the Arduino to all of the sensors. Start from the Arduino and work North West South (skip) Face Align the other cables as show in the picture

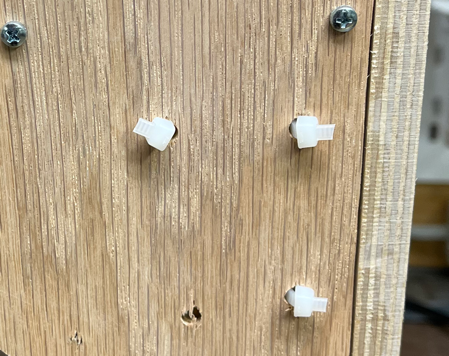
[picture p115: figure]

9 | | Route all of the cables on the inside and hold in place by looping a zip-tie from the back, around the cable, and back out again. Tie in place and cut off excess zip tie.

Assembling the Face Plate

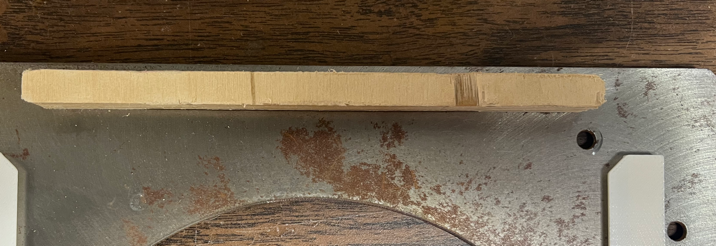
[picture p116: figure]

1 | Install the paper guide using the ½” wood screws. Note the orientation of the two mounting screws on the right of the paper

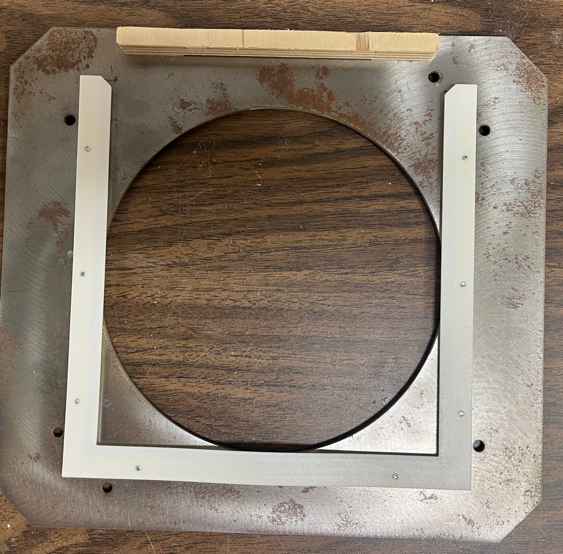
[picture p117: figure]

2 | Using the 3mm x 5 screws, attach the target paper guide onto the face plate. Insert the screws, but do not tighten completely. Tighten starting from the bottom two screws and work bottom to top. Snug the screws, but do not overtighten. The target paper guide is made from 3D printed plastic and will strip the screws if overtightened.

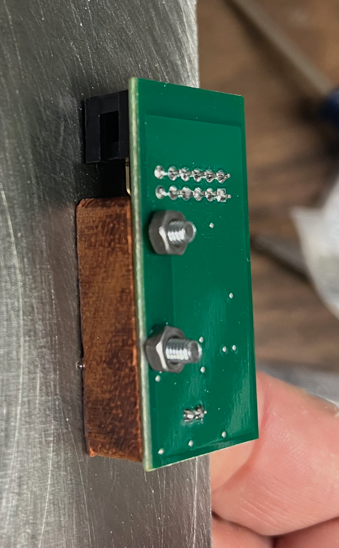
[picture p118: figure]

3 | If using the face strike detector, Using the face plate spacer, install the face sensor using 3mm 18 screws

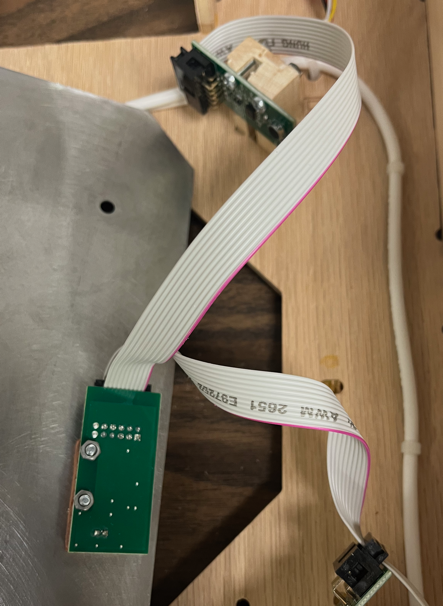
[picture p119: figure]

4 | Attach the face sensor to the flat cable harness

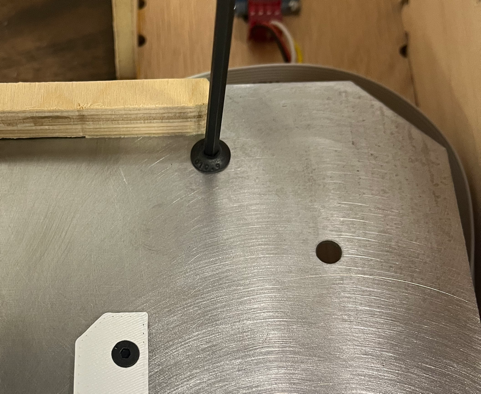
[picture p120: figure]

5 | | Flip the face plate onto the base and attach with the long 5mm screws. Do not overtighten

Installing the Face Plate

The Club target comes with a general-purpose face plate that is assembled for your particular discipline.

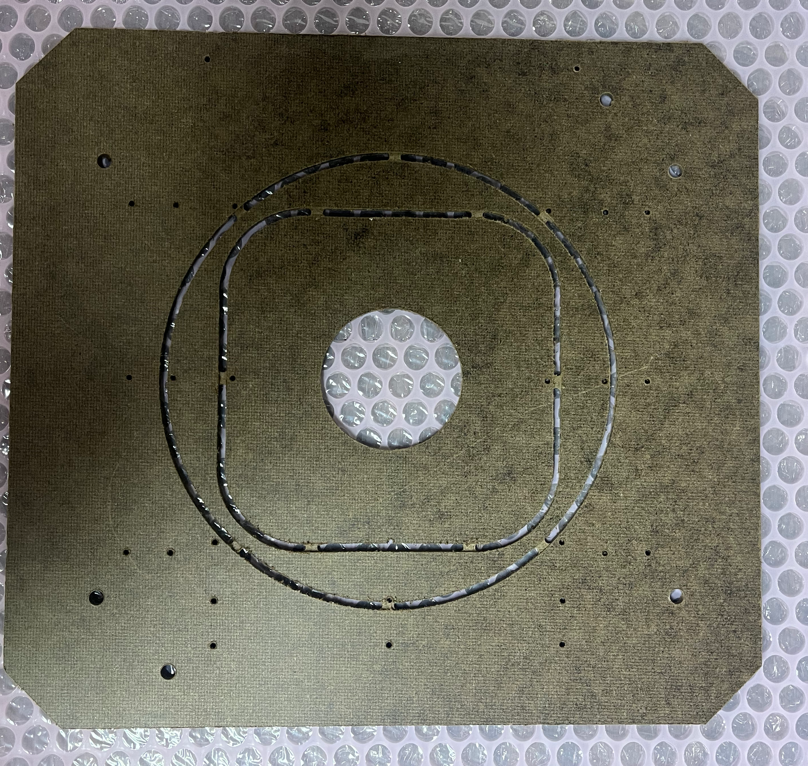
[picture p121: figure]

1 | Select the target option you need Rifle 5 Bull Rifle Pistol
2 | Remove the unused target options

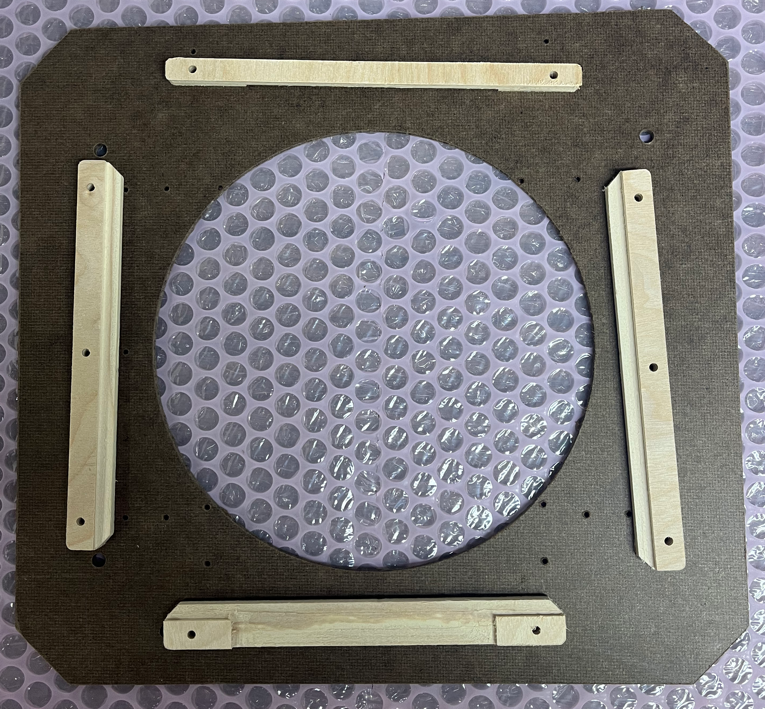
[picture p122: figure]

3 | Locate the target guides. Note that there are Paper Guide (top) Sides (2x) Bottom 1 Use the 3/8x4 screws to attach to the face plate.

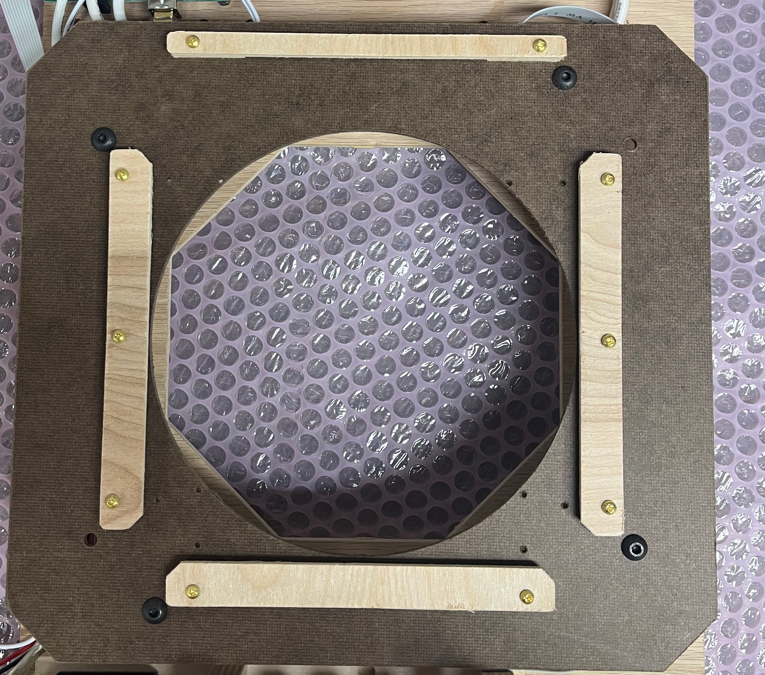
[picture p123: figure]

4 | Install the target plate to the club target

DOWNLOADING AND INSTALLING PC SOFTWARE

Click the link below to go to the downloads page

https://free-e-target.com/downloads/

Look for the PC Software section and download the software (Figure 9)

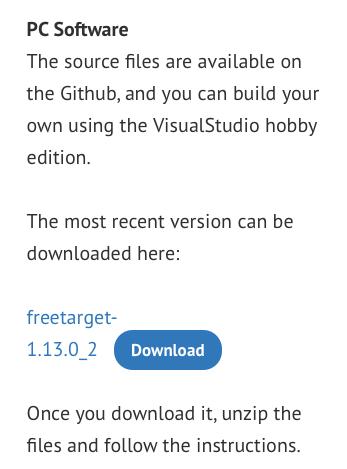
[picture p124: figure]

Figure 9: Download Software

Unzip the software and install on your PC.

Connect the USB cable between the target holder and the PC.

STARTING UP

Launch the PC program and look for the setup icon (GEAR WHEEL) in the upper right corner (See Figure 10)

Figure 10: Setup Icon Location

Enter all of the setup information needed in Figures 9, 10, 11, and 12

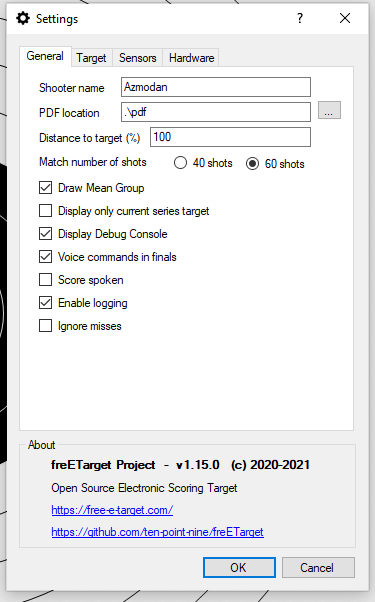
[picture p125: figure]
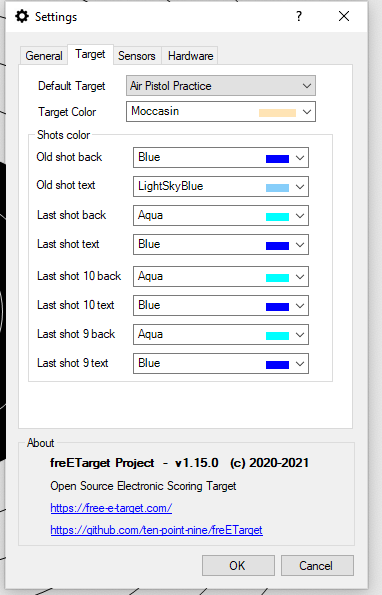
[picture p126: figure]
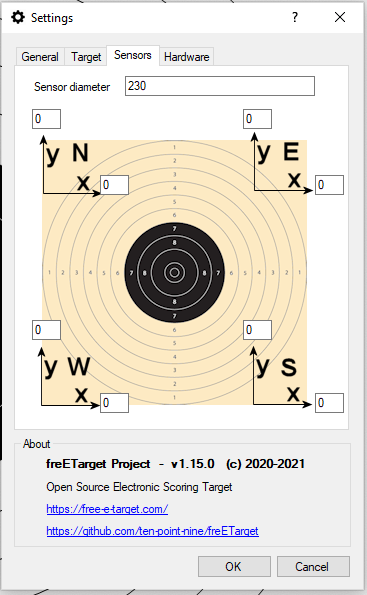
[picture p127: figure]
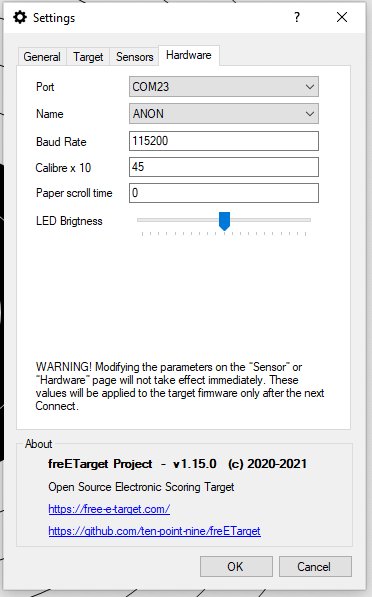
[picture p128: figure]

Figure 11: General Settings | Figure 12: Target Settings | Figure 13: Sensor Adjustment | Figure 14: Hardware Interface

Figure 11: This allows you to enter the shooter name and how information will be stored.

Figure 12: Choose the target you will be shooting against and the colours you will be using.

Figure 13: Fine tune the sensor position to adjust for assembly errors

Figure 14: Interface to the target hardware.

Press to begin a session.

Refer to the Commissioning Instructions from the web site. This will give you a quick summary of how the system is working

TROUBLESHOOTING

The boards are tested before shipment, but a lot can happen between the last test and the first shot. If your system is not working, please follow the trouble shooing guide below before sending an email to freETarget.com

PC Program complains “Database Check Fails..: | - Security issue with some antivirus software - Try running as administrator - Disabling antivirus
PC Program cannot see target | - The Arduino uses a CH340 which may not have a driver on your PC - Follow the instructions at https://sparks.gogo.co.nz/ch340.html to load in the correct driver
No Shots Registered | - Check that the USB cable is attached - Check that the correct Serial port is set in the setup - Check that the wiring harness is attached to all of the sensors - Tap each of the sensors. Do the three LEDs blink?
Shots show up but in the wrong place | - From the firing line, shoot a blank shot - Do the three LEDs blink? - Yes, set a new trip point - No, Check all of the wiring - Verify that the sensors North – West are in the correct order
The shots show up but rotated 90 degrees | - Verify the order of the sensors and correct
The shots are the mirror image left-right | - The sensors are reversed. Switch the positions of NORTH-EAST and SOUTH-WEST

APPENDIX A – freETarget Components

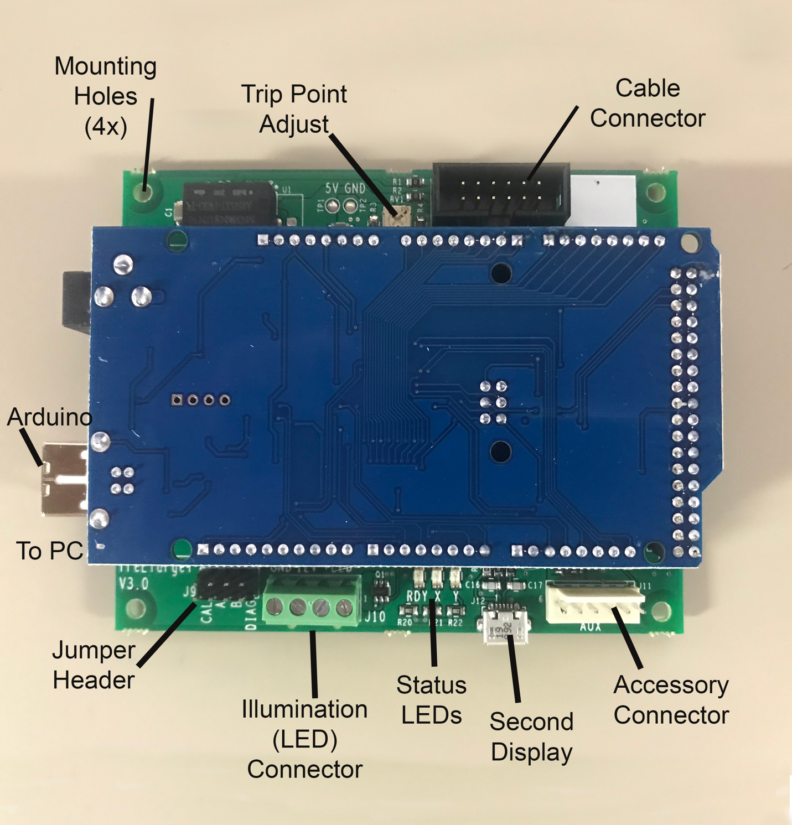
[picture p129: figure]
