kirkholt/freETarget/Mechanical/CAD Files/FRE-000 FREE E TARGET ASSEMBLY.pdf

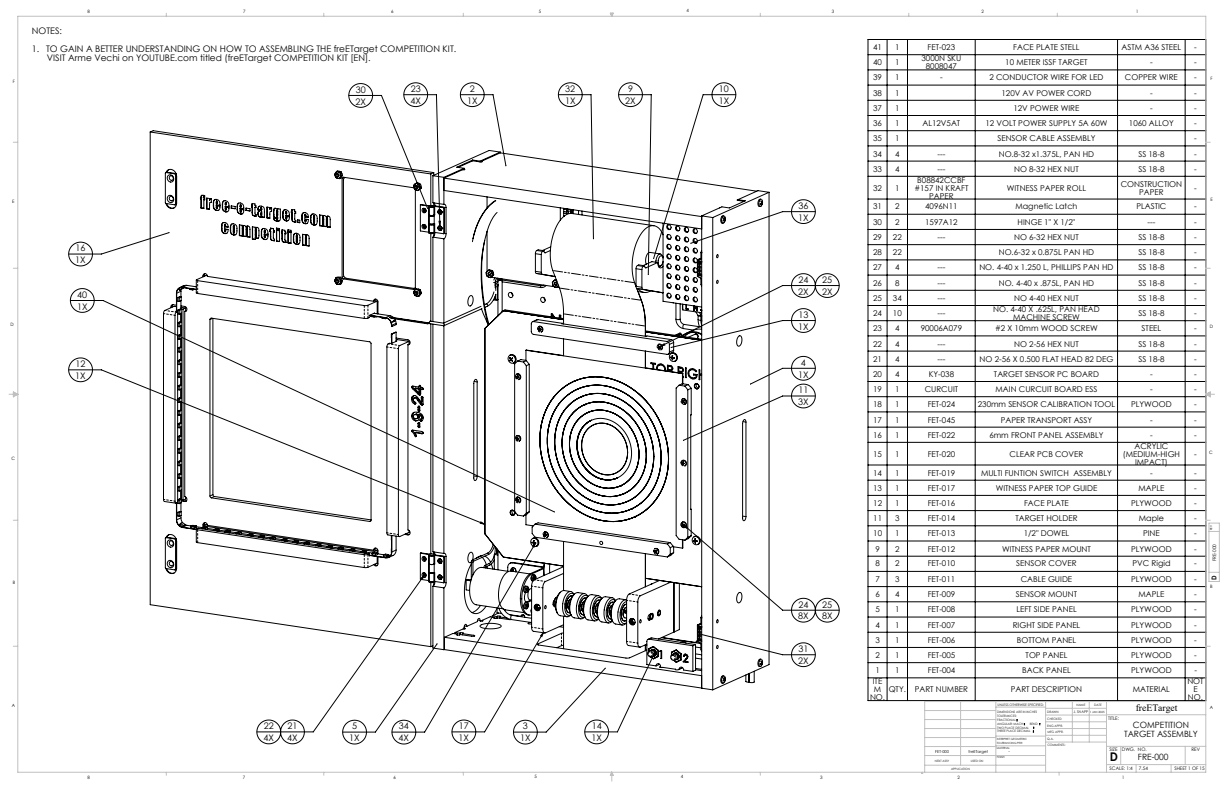
[picture p202: page 1]
FREV FRE-000; SHEET 1 OF 15; TARGET ASSEMBLY; J. SNAPP 1 JAN 2025; SCALE: 1:4 7.54; DWG. NO.; REV; freETarget NAME; DATE; MFG APPR.; ENG APPR.; INTERPRET GEOMETRIC TOLERANCING PER:; ANGULAR: MACH; BEND; NEXT ASSY; USED ON

NOTES:
1. TO GAIN A BETTER UNDERSTANDING ON HOW TO ASSEMBLING THE freETarget COMPETITION KIT.
VISIT Arme Vechi on YOUTUBE.com titled (freETarget COMPETITION KIT [EN].

41 | 1 | FET-023 | FACE PLATE STELL | ASTM A36 STEEL | -
40 | 1 | 3000N SKU 8008047 | 10 METER ISSF TARGET | - | -
39 | 1 | - | 2 CONDUCTOR WIRE FOR LED | COPPER WIRE | -
38 | 1 | | 120V AV POWER CORD | - | -
37 | 1 | | 12V POWER WIRE | - | -
36 | 1 | AL12V5AT | 12 VOLT POWER SUPPLY 5A 60W | 1060 ALLOY | -
35 | 1 | | SENSOR CABLE ASSEMBLY | | -
34 | 4 | --- | NO.8-32 x1.375L, PAN HD | SS 18-8 | -
33 | 4 | --- | NO 8-32 HEX NUT | SS 18-8 | -
32 | 1 | B08842CCBF #157 IN KRAFT PAPER | WITNESS PAPER ROLL | CONSTRUCTION PAPER | -

31 | 2 | 4096N11 | Magnetic Latch | PLASTIC | -
30 | 2 | 1597A12 | HINGE 1" X 1/2" | --- | -
29 | 22 | --- | NO 6-32 HEX NUT | SS 18-8 | -
28 | 22 | | NO.6-32 x 0.875L PAN HD | SS 18-8 | -
27 | 4 | --- | NO. 4-40 x 1.250 L, PHILLIPS PAN HD | SS 18-8 | -
26 | 8 | --- | NO. 4-40 x .875L, PAN HD | SS 18-8 | -
25 | 34 | --- | NO 4-40 HEX NUT | SS 18-8 | -
24 | 10 | --- | NO. 4-40 X .625L, PAN HEAD MACHINE SCREW | SS 18-8 | -
23 | 4 | 90006A079 | #2 X 10mm WOOD SCREW | STEEL | -
22 | 4 | --- | NO 2-56 HEX NUT | SS 18-8 | -
21 | 4 | --- | NO 2-56 X 0.500 FLAT HEAD 82 DEG | SS 18-8 | -
20 | 4 | KY-038 | TARGET SENSOR PC BOARD | - | -
19 | 1 | CURCUIT | MAIN CURCUIT BOARD ESS | - | -
18 | 1 | FET-024 | 230mm SENSOR CALIBRATION TOOL | PLYWOOD | -
17 | 1 | FET-045 | PAPER TRANSPORT ASSY | - | -
16 | 1 | FET-022 | 6mm FRONT PANEL ASSEMBLY | - | -
15 | 1 | FET-020 | CLEAR PCB COVER | ACRYLIC (MEDIUM-HIGH IMPACT) | -

14 | 1 | FET-019 | MULTI FUNTION SWITCH ASSEMBLY | - | -
13 | 1 | FET-017 | WITNESS PAPER TOP GUIDE | MAPLE | -
12 | 1 | FET-016 | FACE PLATE | PLYWOOD | -
11 | 3 | FET-014 | TARGET HOLDER | Maple | -
10 | 1 | FET-013 | 1/2" DOWEL | PINE | -
9 | 2 | FET-012 | WITNESS PAPER MOUNT | PLYWOOD | -
8 | 2 | FET-010 | SENSOR COVER | PVC Rigid | -
7 | 3 | FET-011 | CABLE GUIDE | PLYWOOD | -
6 | 4 | FET-009 | SENSOR MOUNT | MAPLE | -
5 | 1 | FET-008 | LEFT SIDE PANEL | PLYWOOD | -
4 | 1 | FET-007 | RIGHT SIDE PANEL | PLYWOOD | -
3 | 1 | FET-006 | BOTTOM PANEL | PLYWOOD | -
2 | 1 | FET-005 | TOP PANEL | PLYWOOD | -
1 | 1 | FET-004 | BACK PANEL | PLYWOOD | -
ITE M NO. | QTY. | PART NUMBER | PART DESCRIPTION | MATERIAL | NOT E NO.

UNLESS OTHERWISE SPECIFIED:

DIMENSIONS ARE IN INCHES
TOLERANCES:
FRACTIONAL
TWO PLACE DECIMAL
THREE PLACE DECIMAL

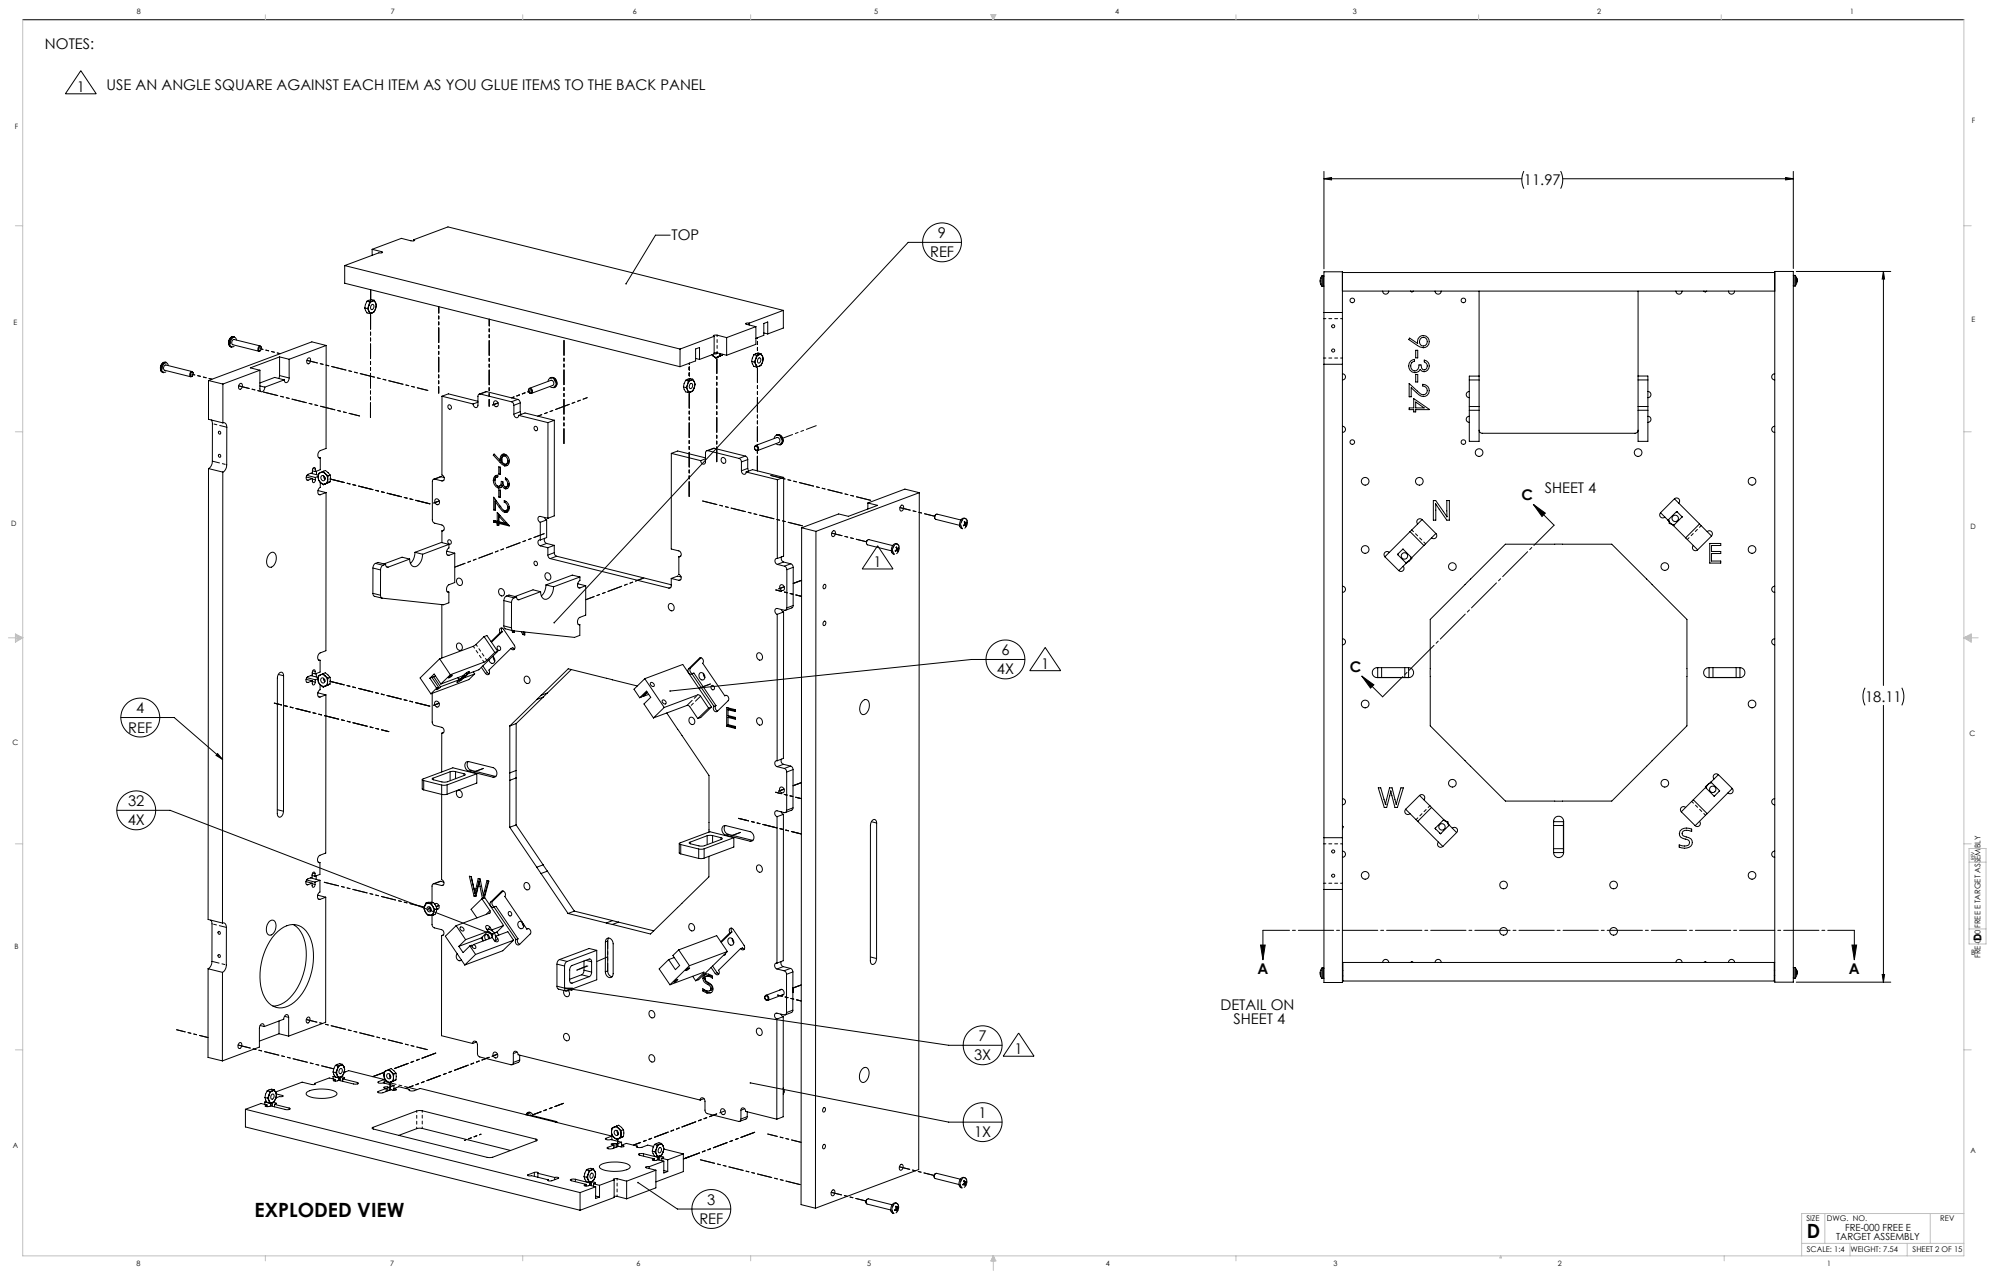
[picture p203: page 2]
C SHEET 4; EXPLODED VIEW; DETAIL ON SHEET 4; FRE-000 FREE E; SCALE: 1:4 WEIGHT: 7.54; SHEET 2 OF 15

USE AN ANGLE SQUARE AGAINST EACH ITEM AS YOU GLUE ITEMS TO THE BACK PANEL

FREV FRE-000 FREE E TARGET ASSEMBLY D

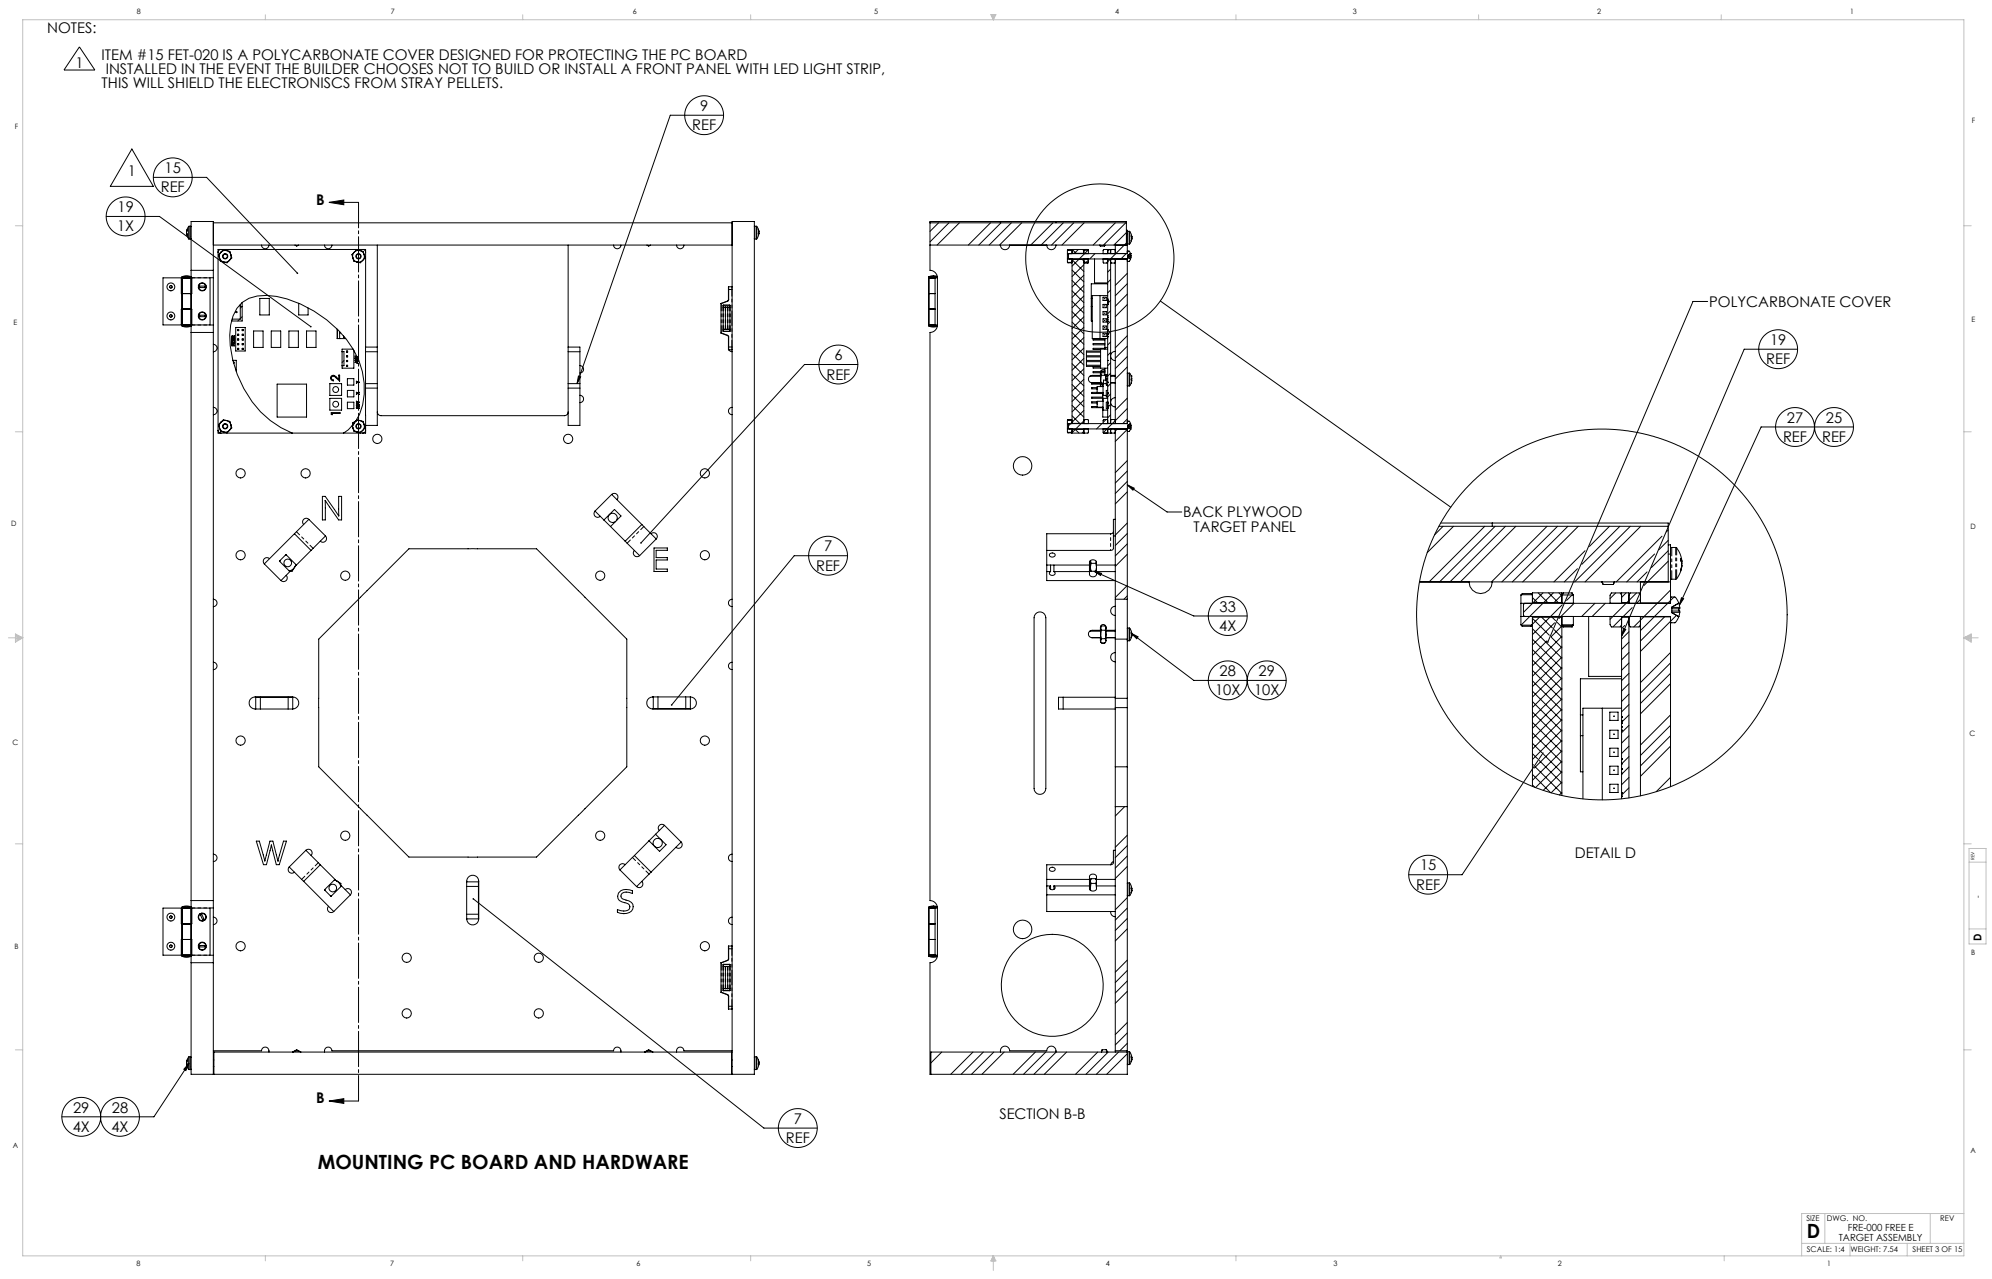
[picture p204: page 3]
SECTION B-B; BACK PLYWOOD TARGET PANEL; DETAIL D; POLYCARBONATE COVER; SCALE: 1:4 WEIGHT: 7.54; SHEET 3 OF 15

NOTES:
ITEM #15 FET-020 IS A POLYCARBONATE COVER DESIGNED FOR PROTECTING THE PC BOARD
INSTALLED IN THE EVENT THE BUILDER CHOOSES NOT TO BUILD OR INSTALL A FRONT PANEL WITH LED LIGHT STRIP,
THIS WILL SHIELD THE ELECTRONISCS FROM STRAY PELLETS.

MOUNTING PC BOARD AND HARDWARE

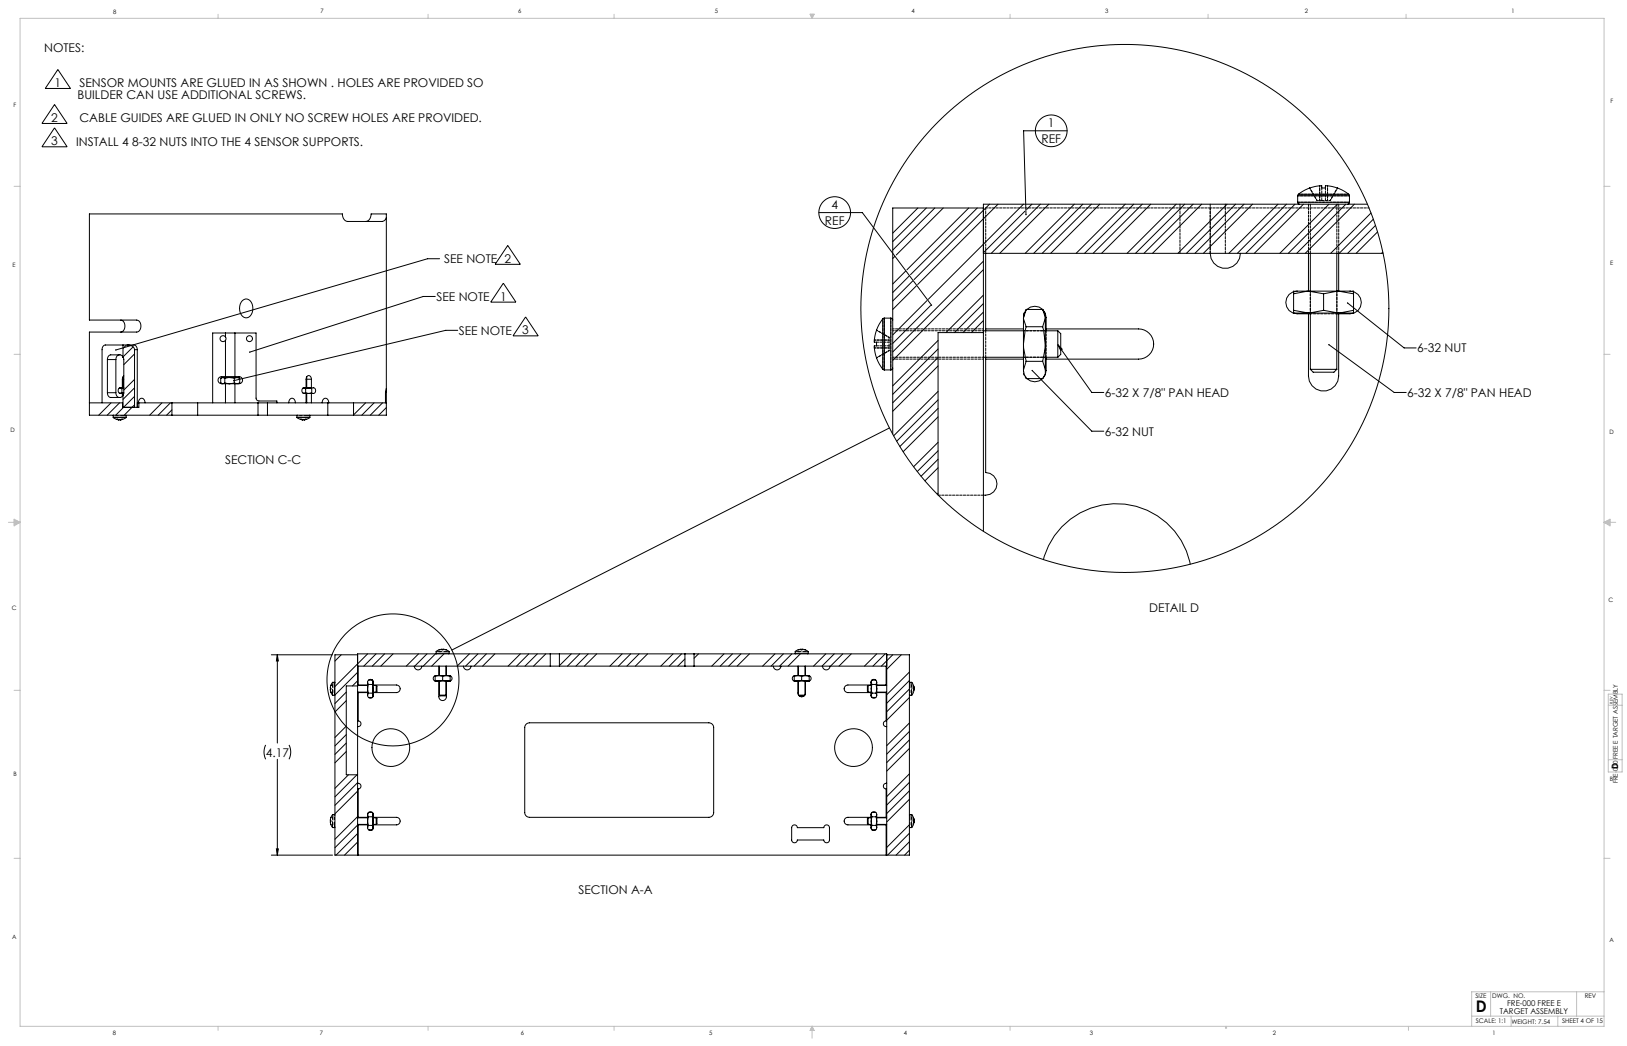
[picture p205: page 4]
SECTION A-A; DETAIL D; 6-32 X 7/8" PAN HEAD; 6-32 NUT; SECTION C-C; SEE NOTE 1; SEE NOTE 2; SEE NOTE 3; CABLE GUIDES ARE GLUED IN ONLY NO SCREW HOLES ARE PROVIDED.; SCALE: 1:1 WEIGHT: 7.54; SHEET 4 OF 15

1 SENSOR MOUNTS ARE GLUED IN AS SHOWN . HOLES ARE PROVIDED SO
BUILDER CAN USE ADDITIONAL SCREWS.
3 INSTALL 4 8-32 NUTS INTO THE 4 SENSOR SUPPORTS.

FREV FRE-000 FREE E TARGET ASSEMBLY D

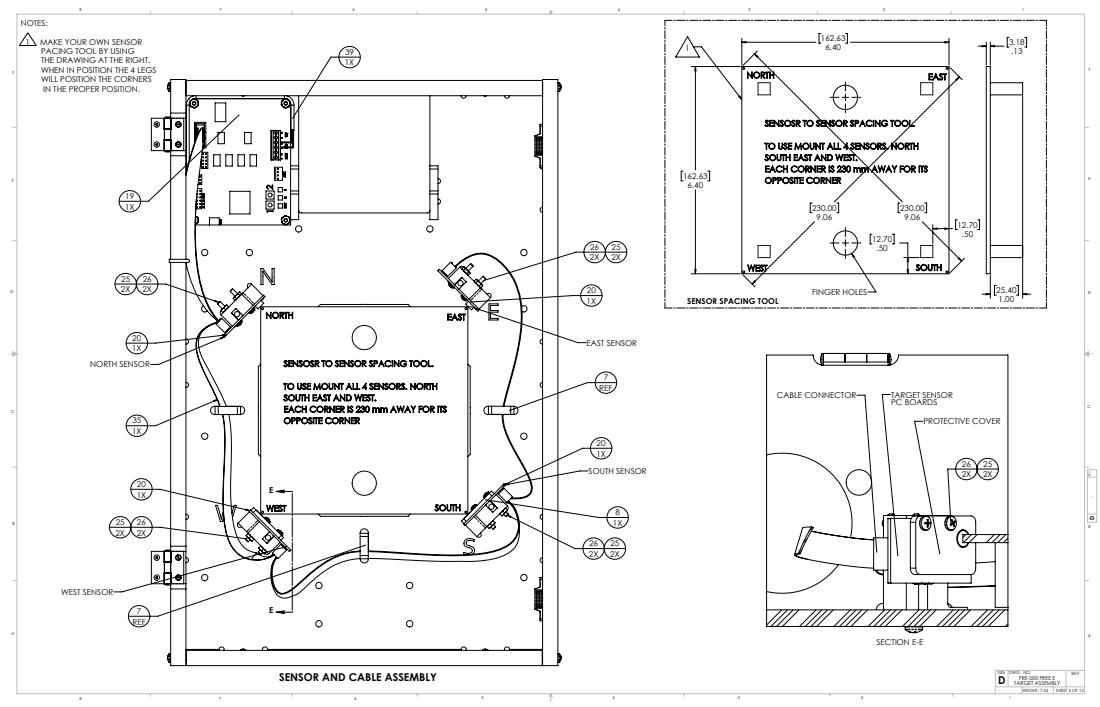
[picture p206: page 5]
EAST SENSOR; SOUTH SENSOR; WEST SENSOR; NORTH SENSOR; SECTION E-E; CABLE CONNECTOR; TARGET SENSOR; PC BOARDS; PROTECTIVE COVER; FINGER HOLES; WEIGHT: 7.54; SHEET 5 OF 15

NOTES:
1 MAKE YOUR OWN SENSOR
PACING TOOL BY USING
THE DRAWING AT THE RIGHT.
WHEN IN POSITION THE 4 LEGS
WILL POSITION THE CORNERS
IN THE PROPER POSITION.

SENSOR SPACING TOOL

SENSOR AND CABLE ASSEMBLY

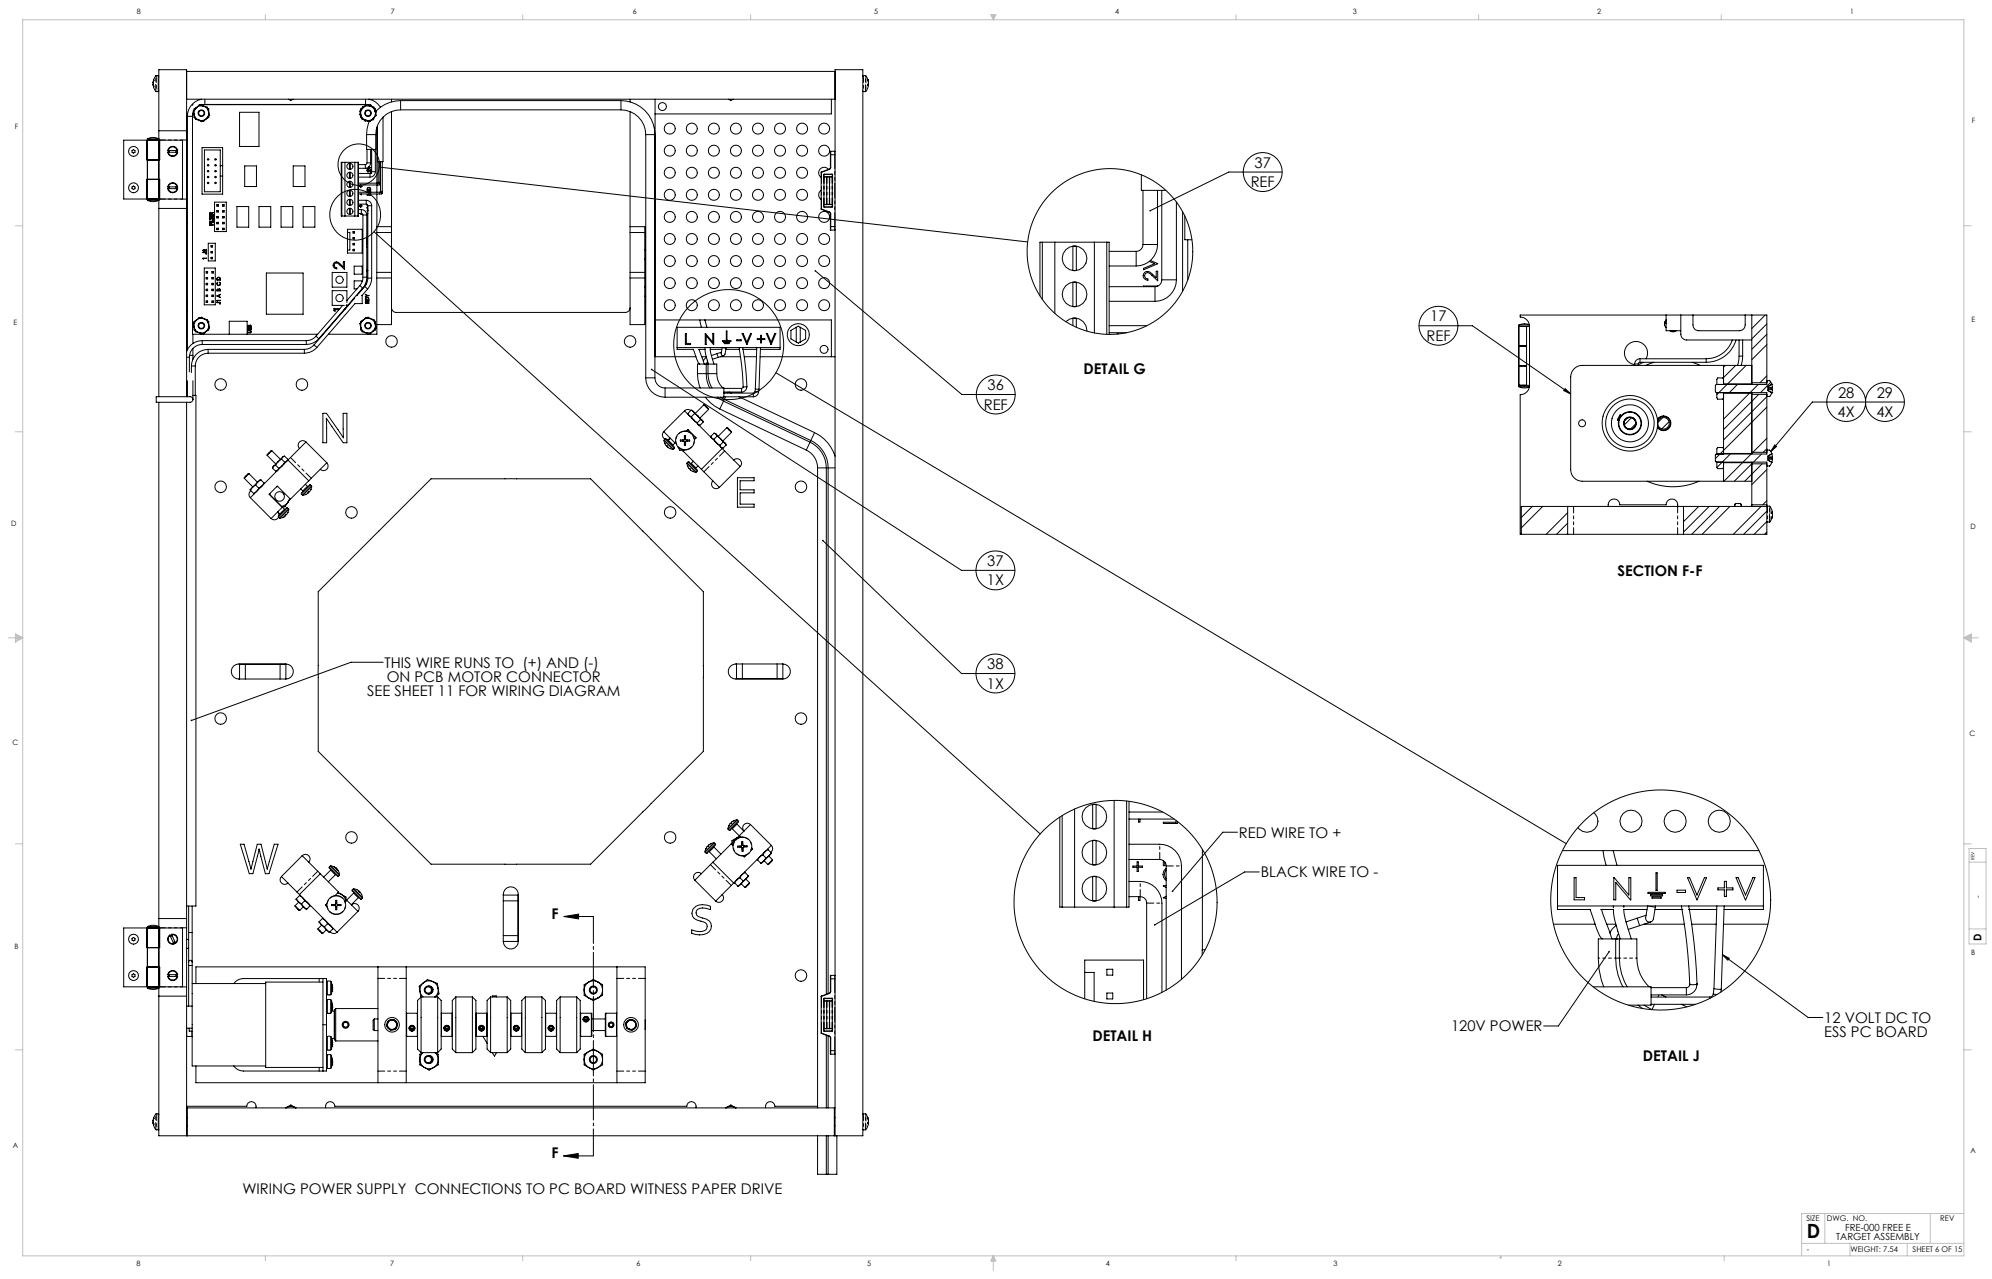
[picture p207: page 6]
DETAIL H; DETAIL G; DETAIL J; 120V POWER; 12 VOLT DC TO; SECTION F-F; WEIGHT: 7.54; SHEET 6 OF 15

THIS WIRE RUNS TO (+) AND (-)
ON PCB MOTOR CONNECTOR
SEE SHEET 11 FOR WIRING DIAGRAM

RED WIRE TO +

BLACK WIRE TO -

ESS PC BOARD

WIRING POWER SUPPLY CONNECTIONS TO PC BOARD WITNESS PAPER DRIVE

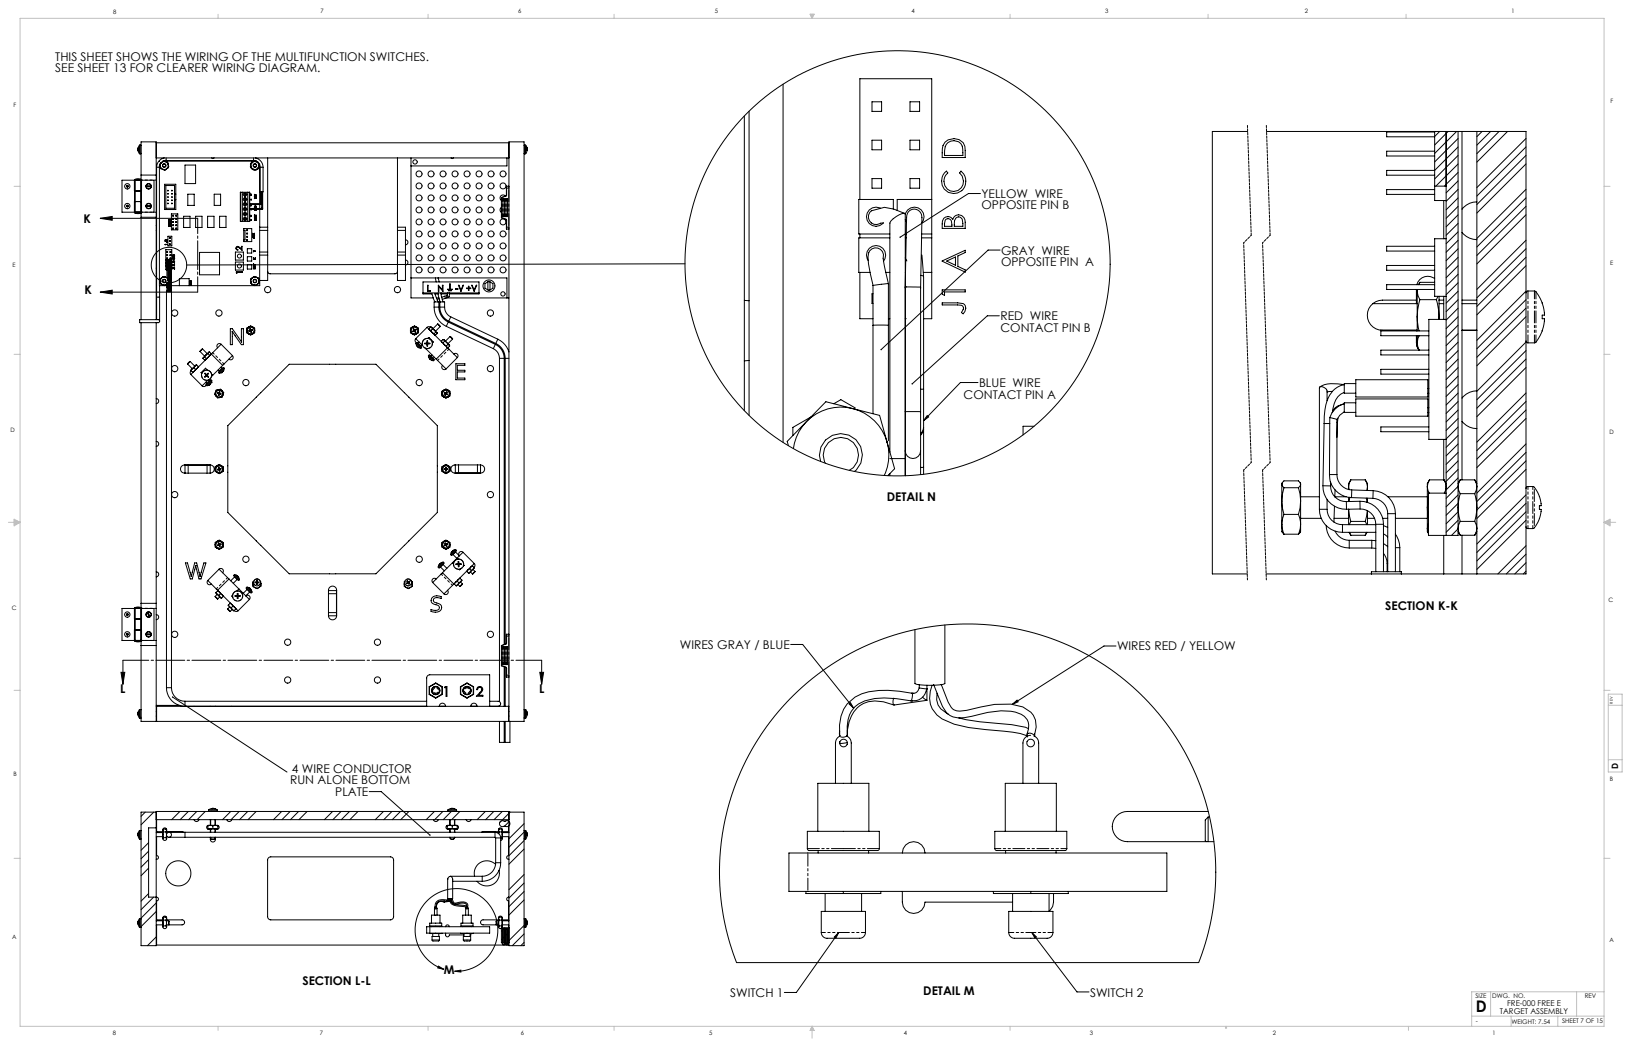
[picture p208: page 7]
GRAY WIRE OPPOSITE PIN A; YELLOW WIRE OPPOSITE PIN B; SECTION L-L; SWITCH 1; DETAIL M; SWITCH 2; WIRES GRAY / BLUE; WIRES RED / YELLOW; DETAIL N; BLUE WIRE CONTACT PIN A; RED WIRE CONTACT PIN B; SECTION K-K; WEIGHT: 7.54; SHEET 7 OF 15

THIS SHEET SHOWS THE WIRING OF THE MULTIFUNCTION SWITCHES.
SEE SHEET 13 FOR CLEARER WIRING DIAGRAM.

4 WIRE CONDUCTOR
RUN ALONE BOTTOM
PLATE

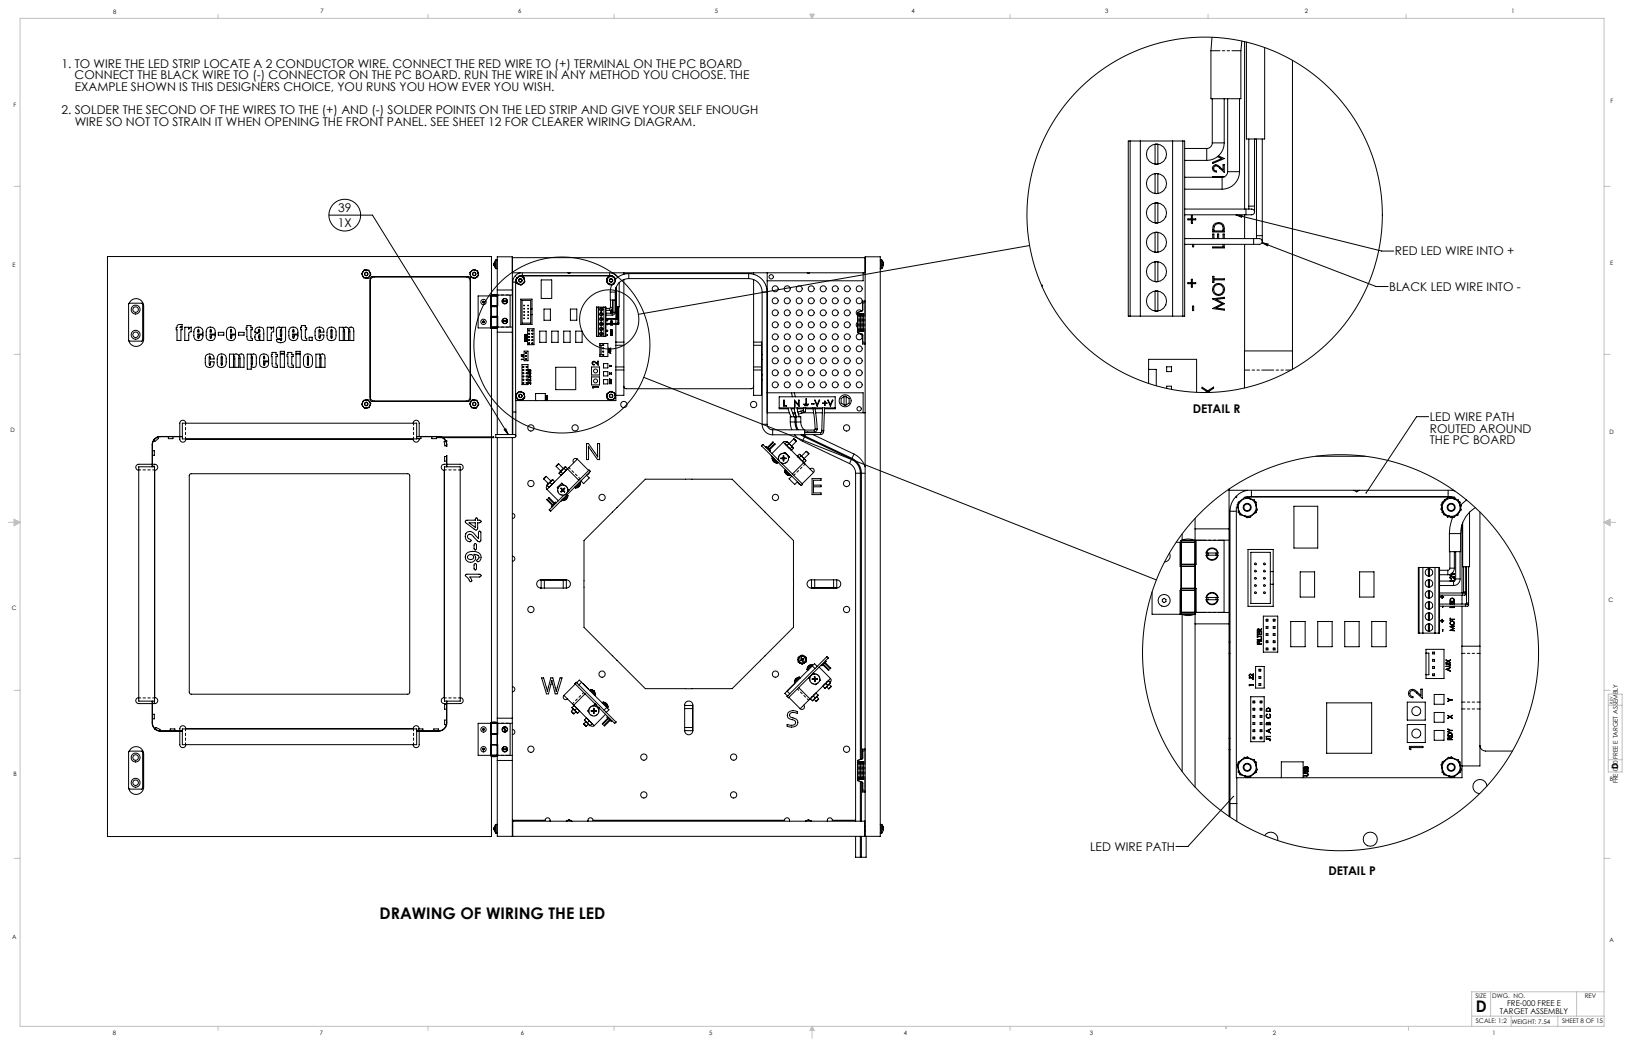
[picture p209: page 8]
DETAIL R; DETAIL P; SCALE: 1:2 WEIGHT: 7.54; SHEET 8 OF 15

1. TO WIRE THE LED STRIP LOCATE A 2 CONDUCTOR WIRE. CONNECT THE RED WIRE TO (+) TERMINAL ON THE PC BOARD
CONNECT THE BLACK WIRE TO (-) CONNECTOR ON THE PC BOARD. RUN THE WIRE IN ANY METHOD YOU CHOOSE. THE
EXAMPLE SHOWN IS THIS DESIGNERS CHOICE, YOU RUNS YOU HOW EVER YOU WISH.
2. SOLDER THE SECOND OF THE WIRES TO THE (+) AND (-) SOLDER POINTS ON THE LED STRIP AND GIVE YOUR SELF ENOUGH
WIRE SO NOT TO STRAIN IT WHEN OPENING THE FRONT PANEL. SEE SHEET 12 FOR CLEARER WIRING DIAGRAM.

FREV FRE-000 FREE E TARGET ASSEMBLY D

RED LED WIRE INTO +

BLACK LED WIRE INTO -

LED WIRE PATH
ROUTED AROUND
THE PC BOARD

DRAWING OF WIRING THE LED

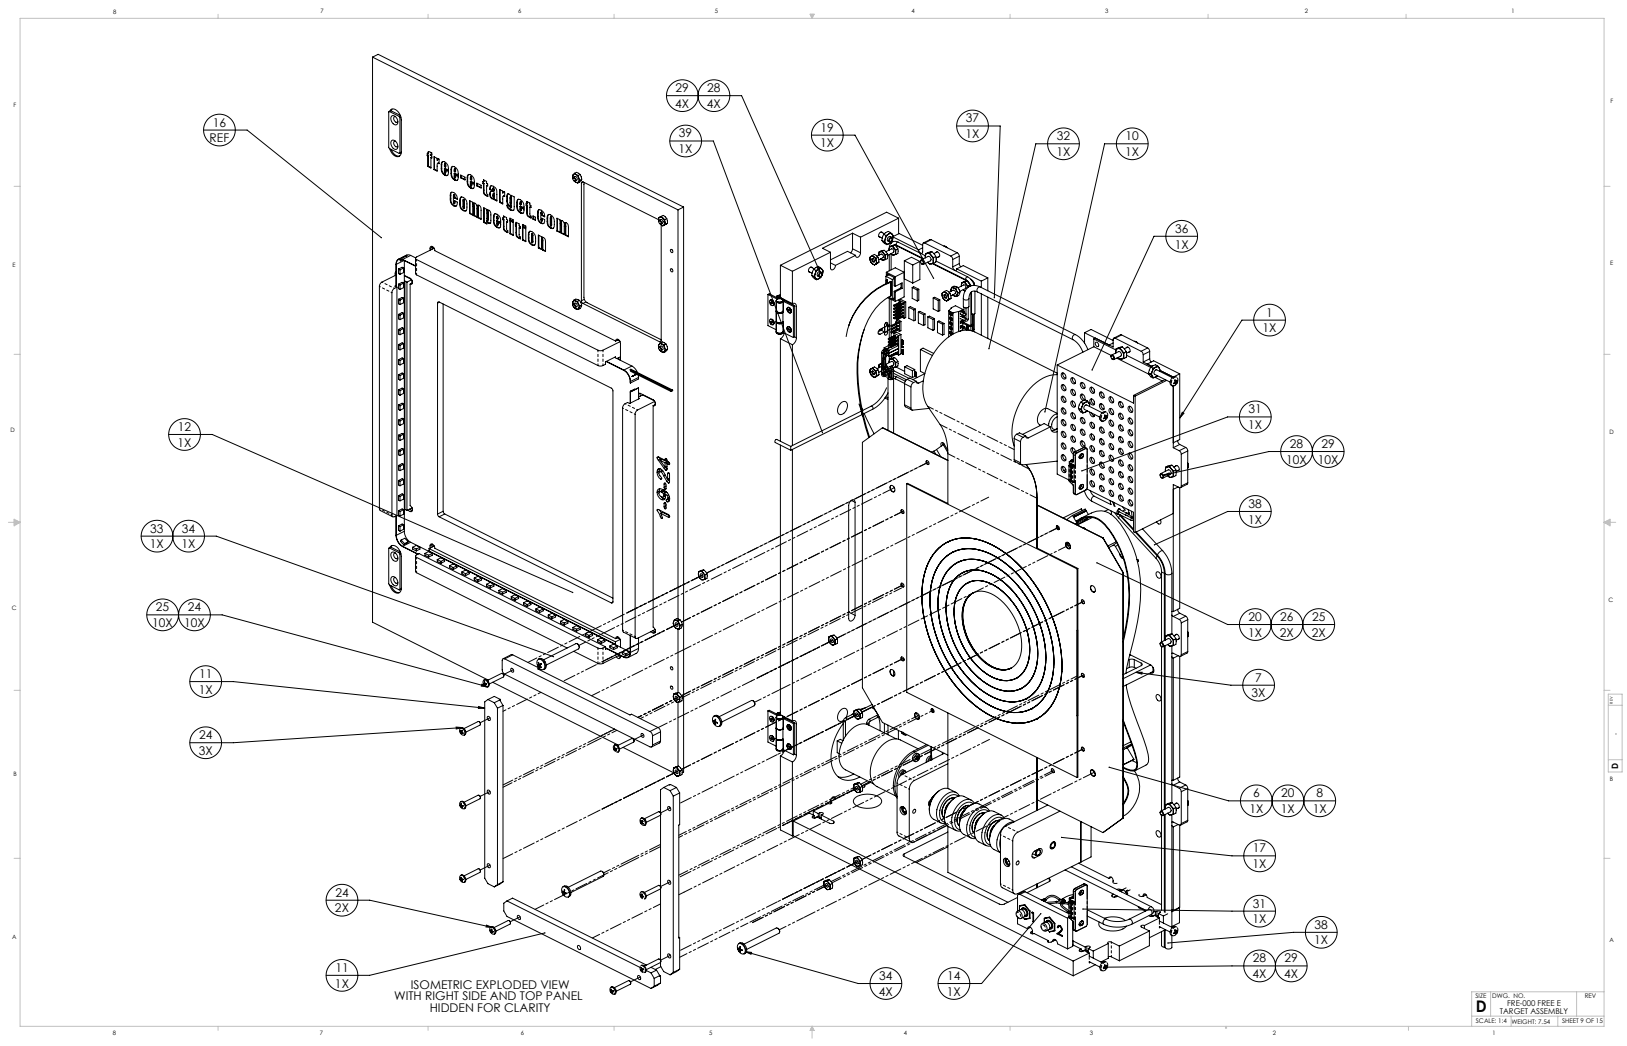
[picture p210: page 9]
SCALE: 1:4 WEIGHT: 7.54; SHEET 9 OF 15

ISOMETRIC EXPLODED VIEW
WITH RIGHT SIDE AND TOP PANEL
HIDDEN FOR CLARITY

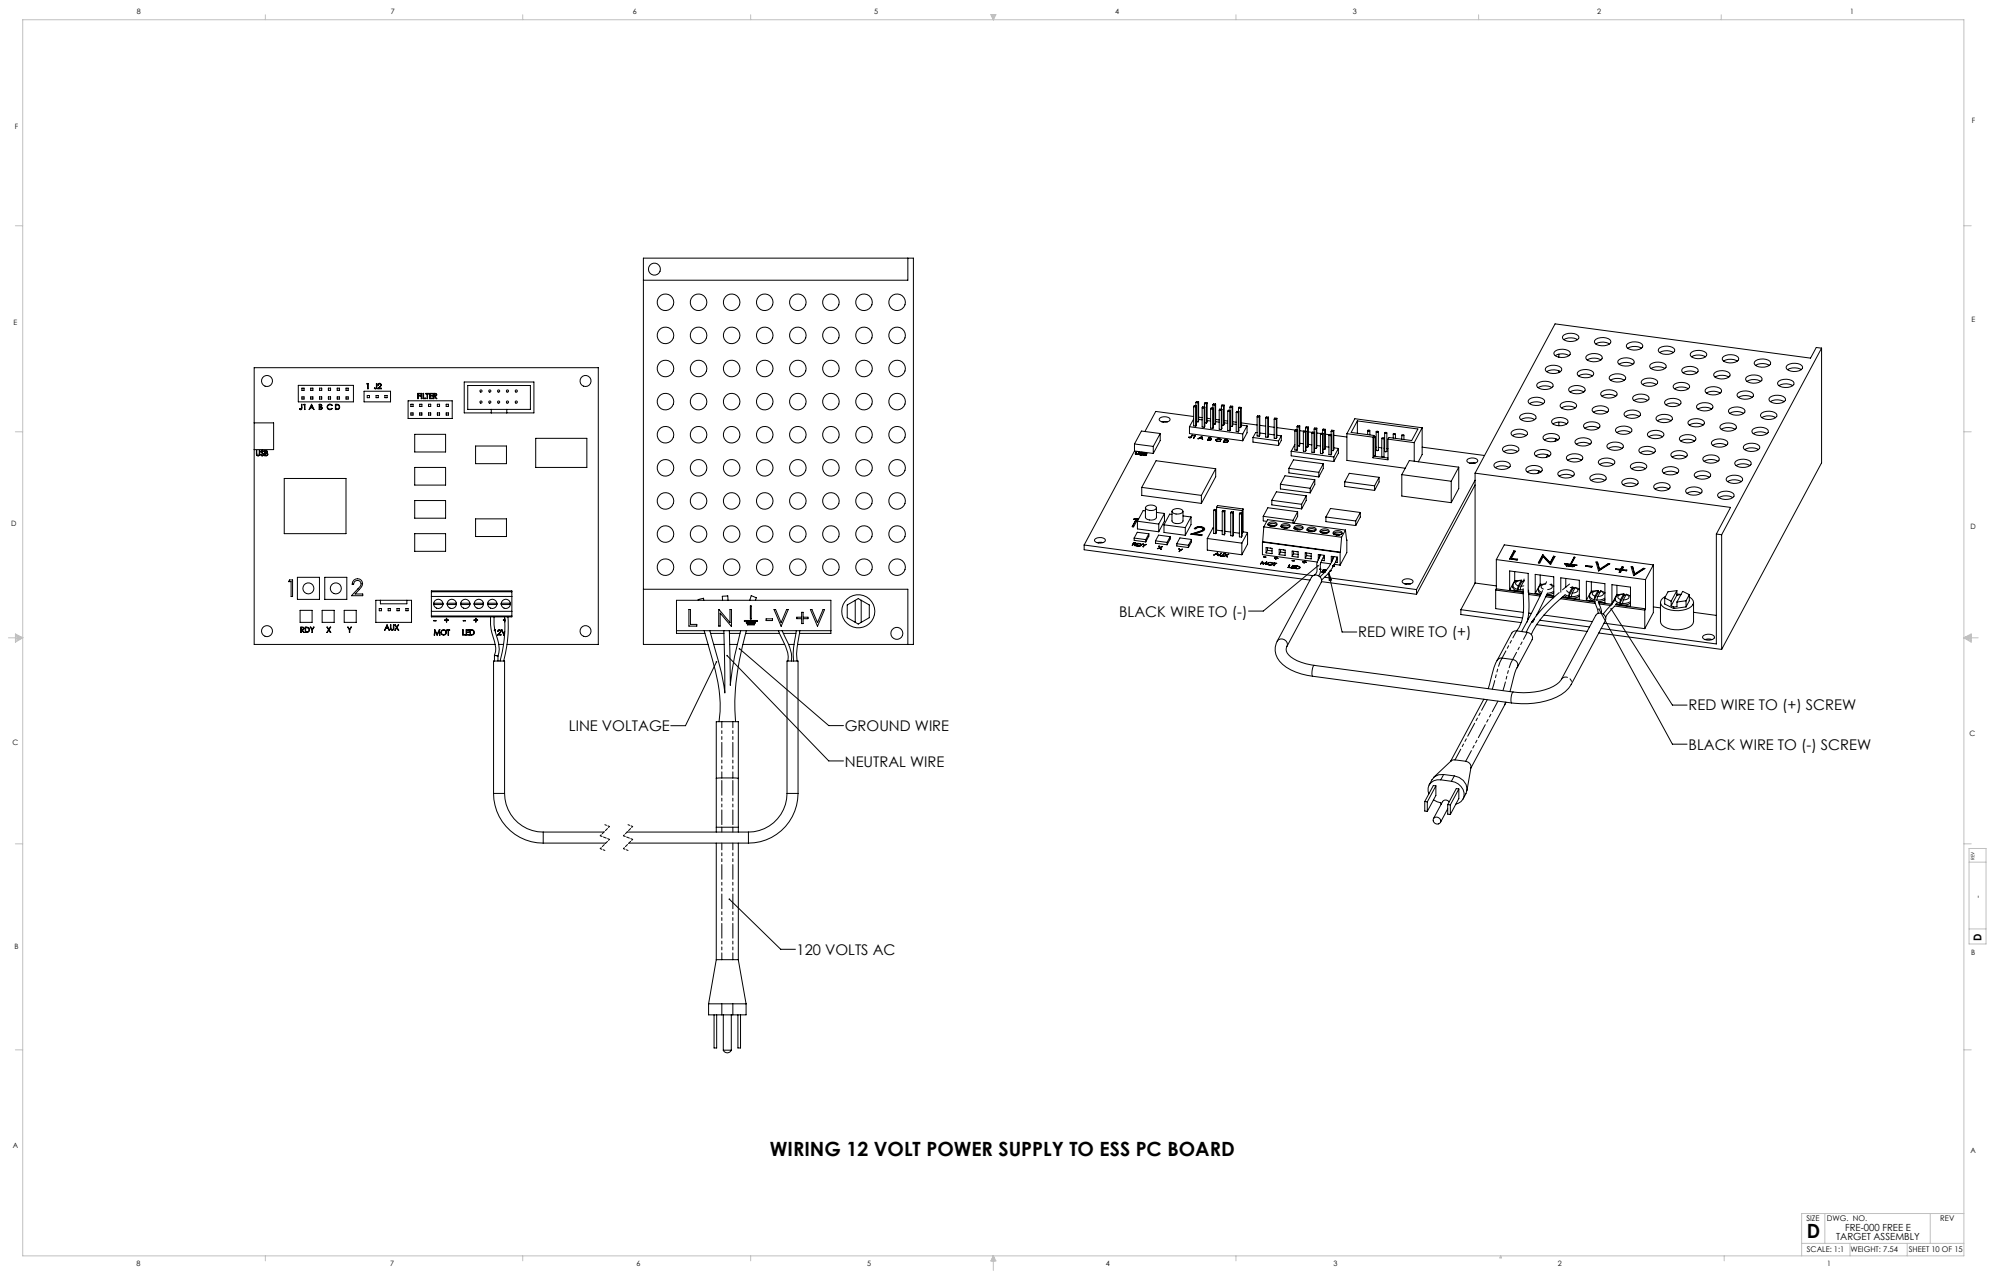
[picture p211: page 10]
120 VOLTS AC; NEUTRAL WIRE; LINE VOLTAGE; GROUND WIRE

BLACK WIRE TO (-)

RED WIRE TO (+)

RED WIRE TO (+) SCREW

BLACK WIRE TO (-) SCREW

WIRING 12 VOLT POWER SUPPLY TO ESS PC BOARD

SCALE: 1:1 WEIGHT: 7.54 SHEET 10 OF 15

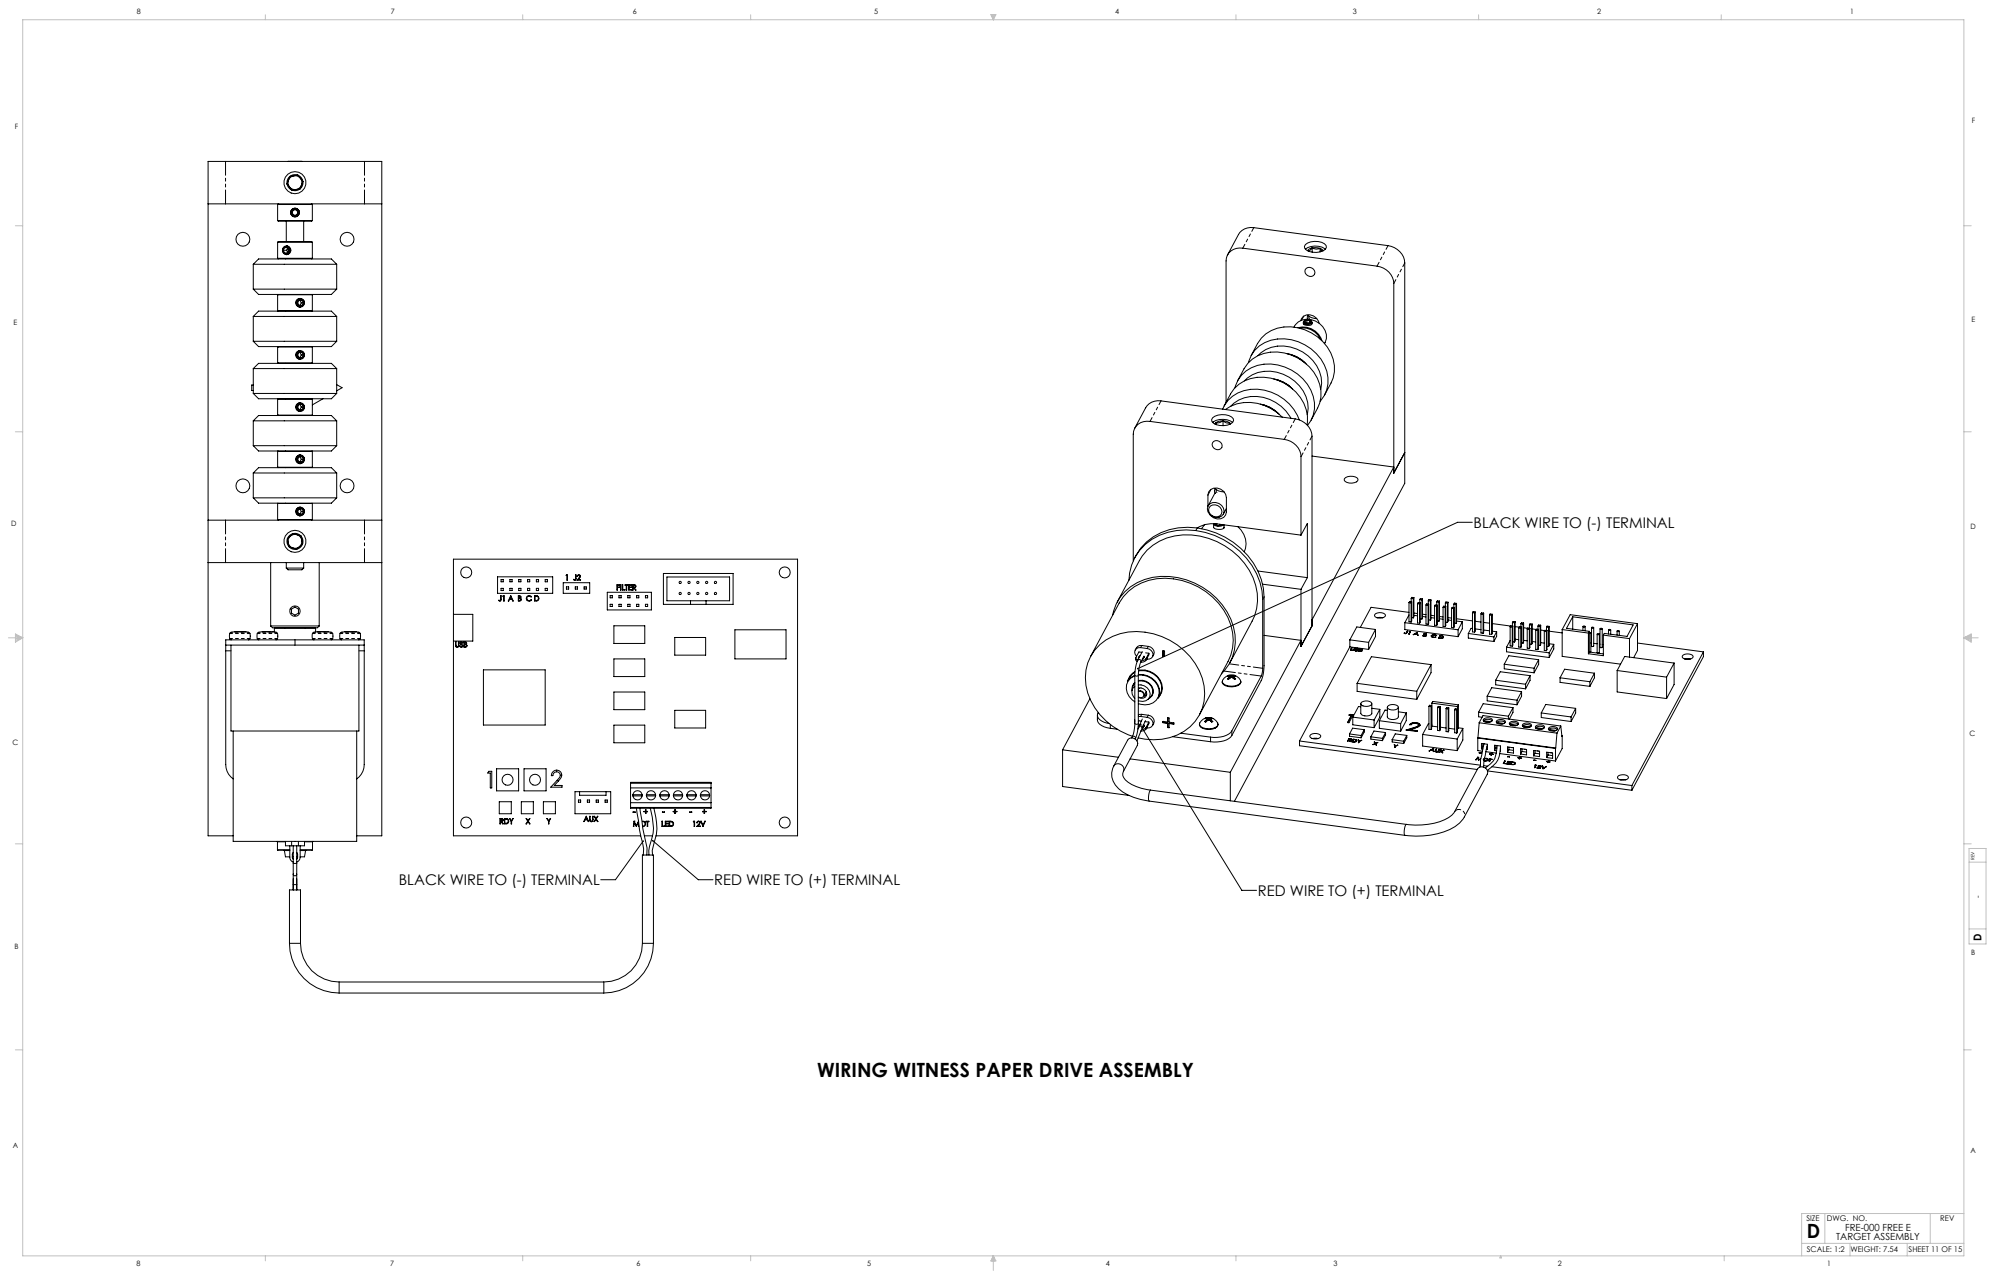
[picture p212: page 11]
BLACK WIRE TO (-) TERMINAL; RED WIRE TO (+) TERMINAL

BLACK WIRE TO (-) TERMINAL

RED WIRE TO (+) TERMINAL

WIRING WITNESS PAPER DRIVE ASSEMBLY

SCALE: 1:2 WEIGHT: 7.54 SHEET 11 OF 15

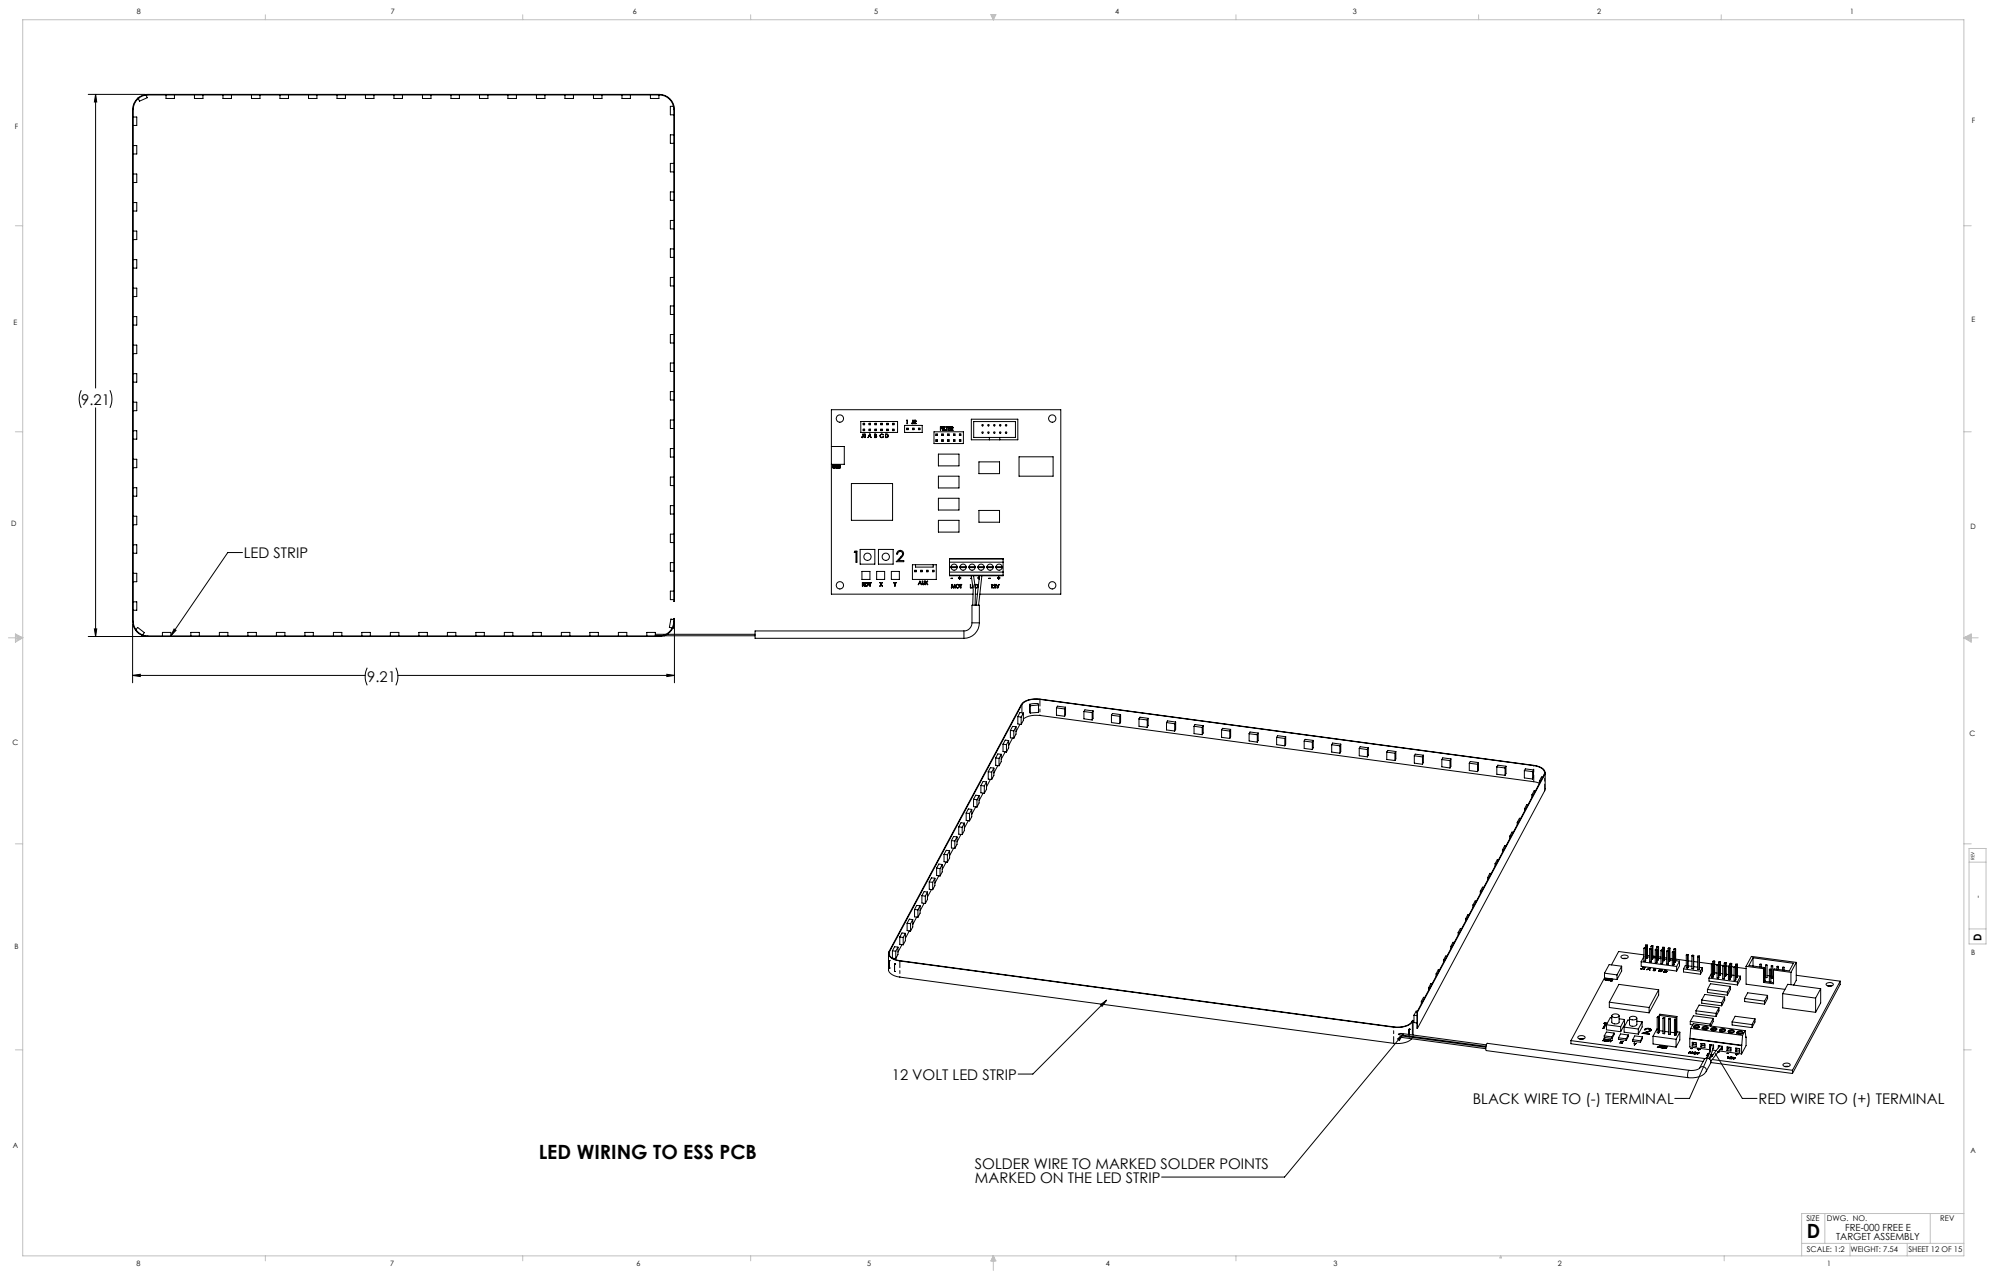
[picture p213: page 12]
LED STRIP; BLACK WIRE TO (-) TERMINAL; RED WIRE TO (+) TERMINAL

12 VOLT LED STRIP

LED WIRING TO ESS PCB

SOLDER WIRE TO MARKED SOLDER POINTS
MARKED ON THE LED STRIP

SCALE: 1:2 WEIGHT: 7.54 SHEET 12 OF 15

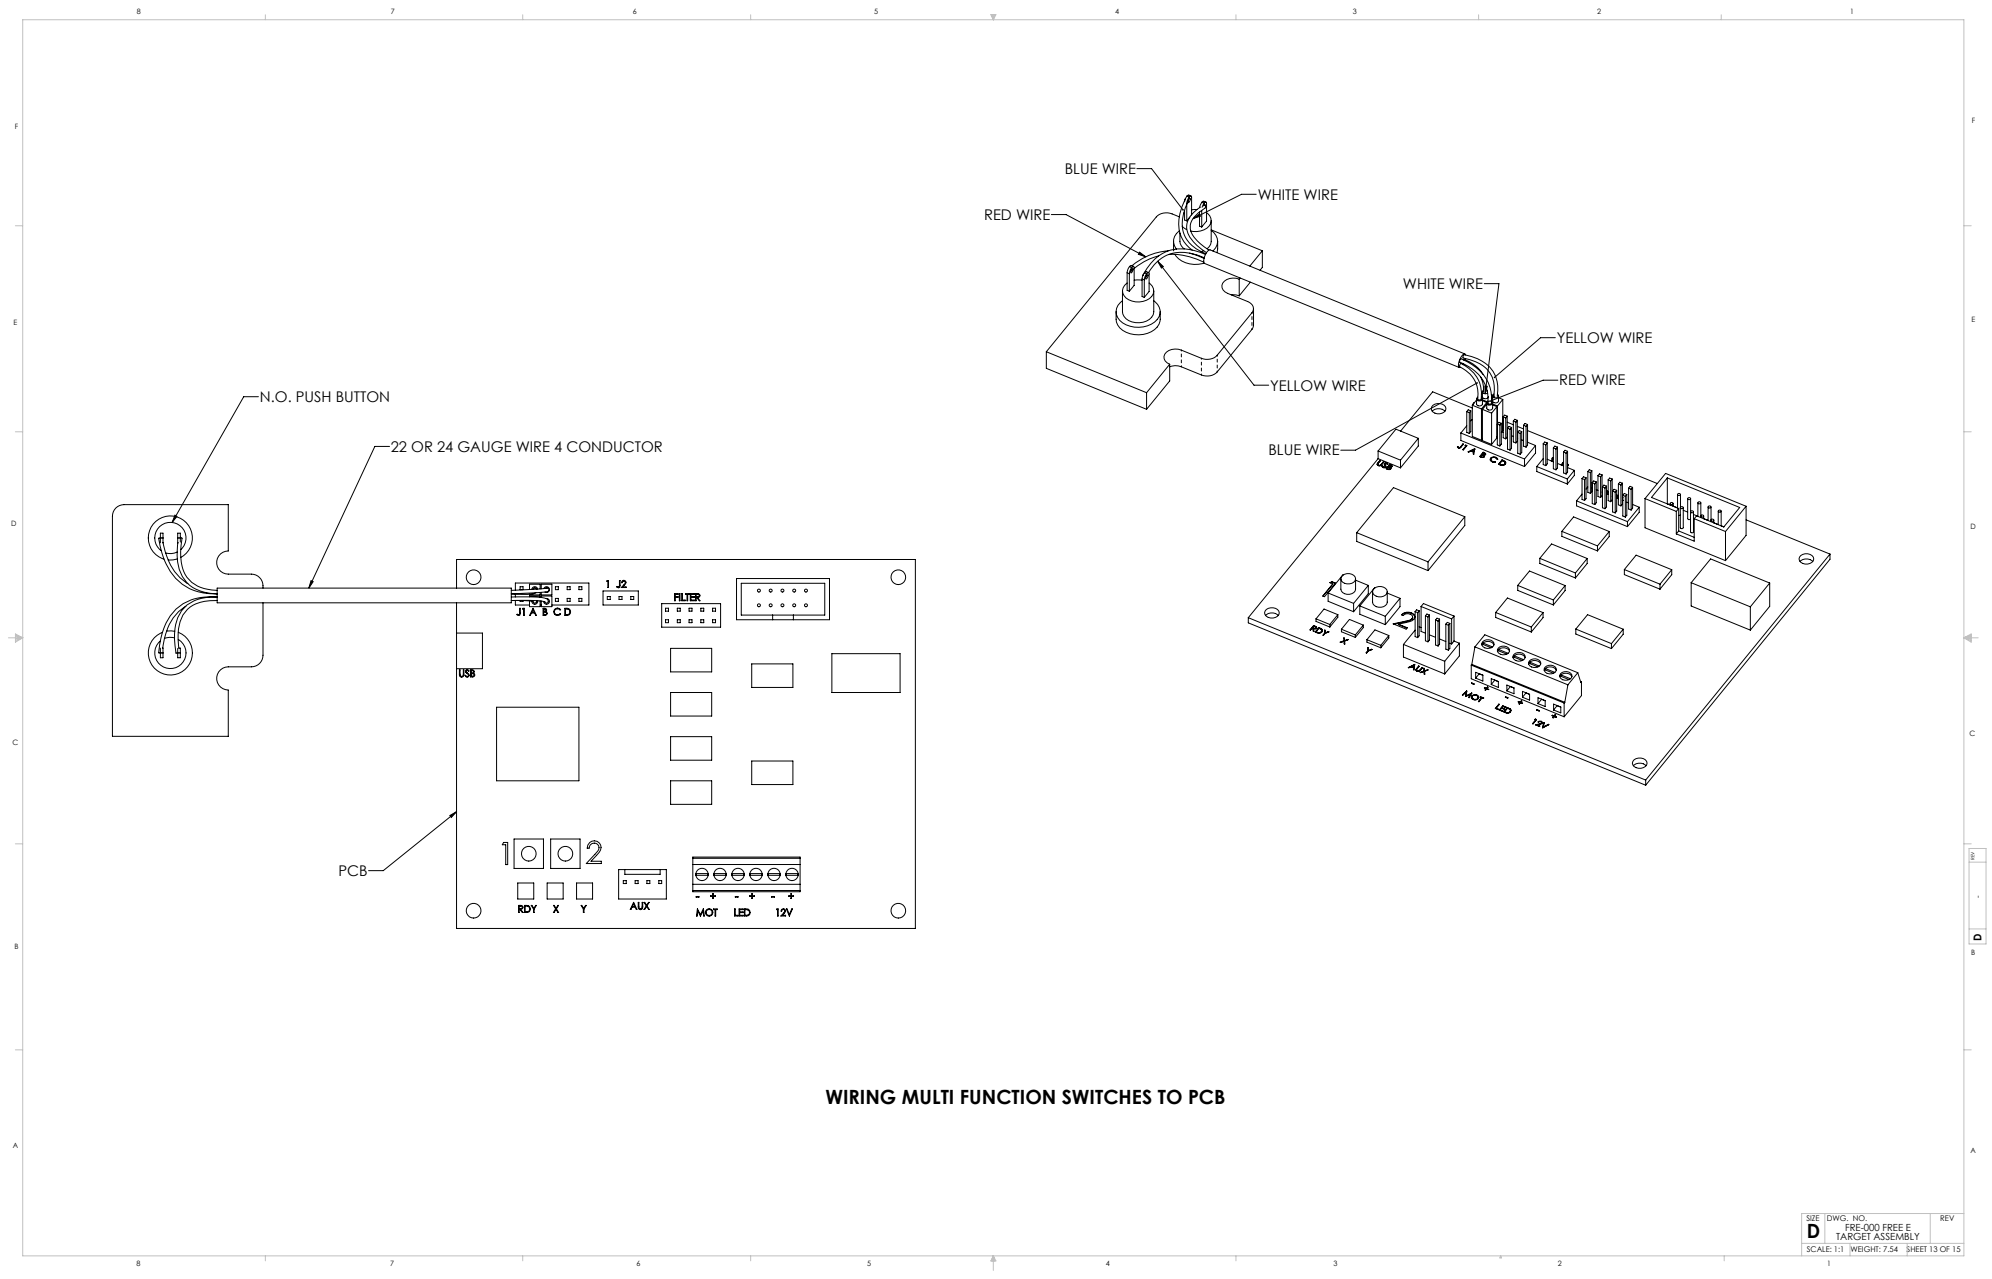
[picture p214: page 13]
N.O. PUSH BUTTON; WHITE WIRE; BLUE WIRE; RED WIRE; YELLOW WIRE

22 OR 24 GAUGE WIRE 4 CONDUCTOR

WIRING MULTI FUNCTION SWITCHES TO PCB

SCALE: 1:1 WEIGHT: 7.54 SHEET 13 OF 15

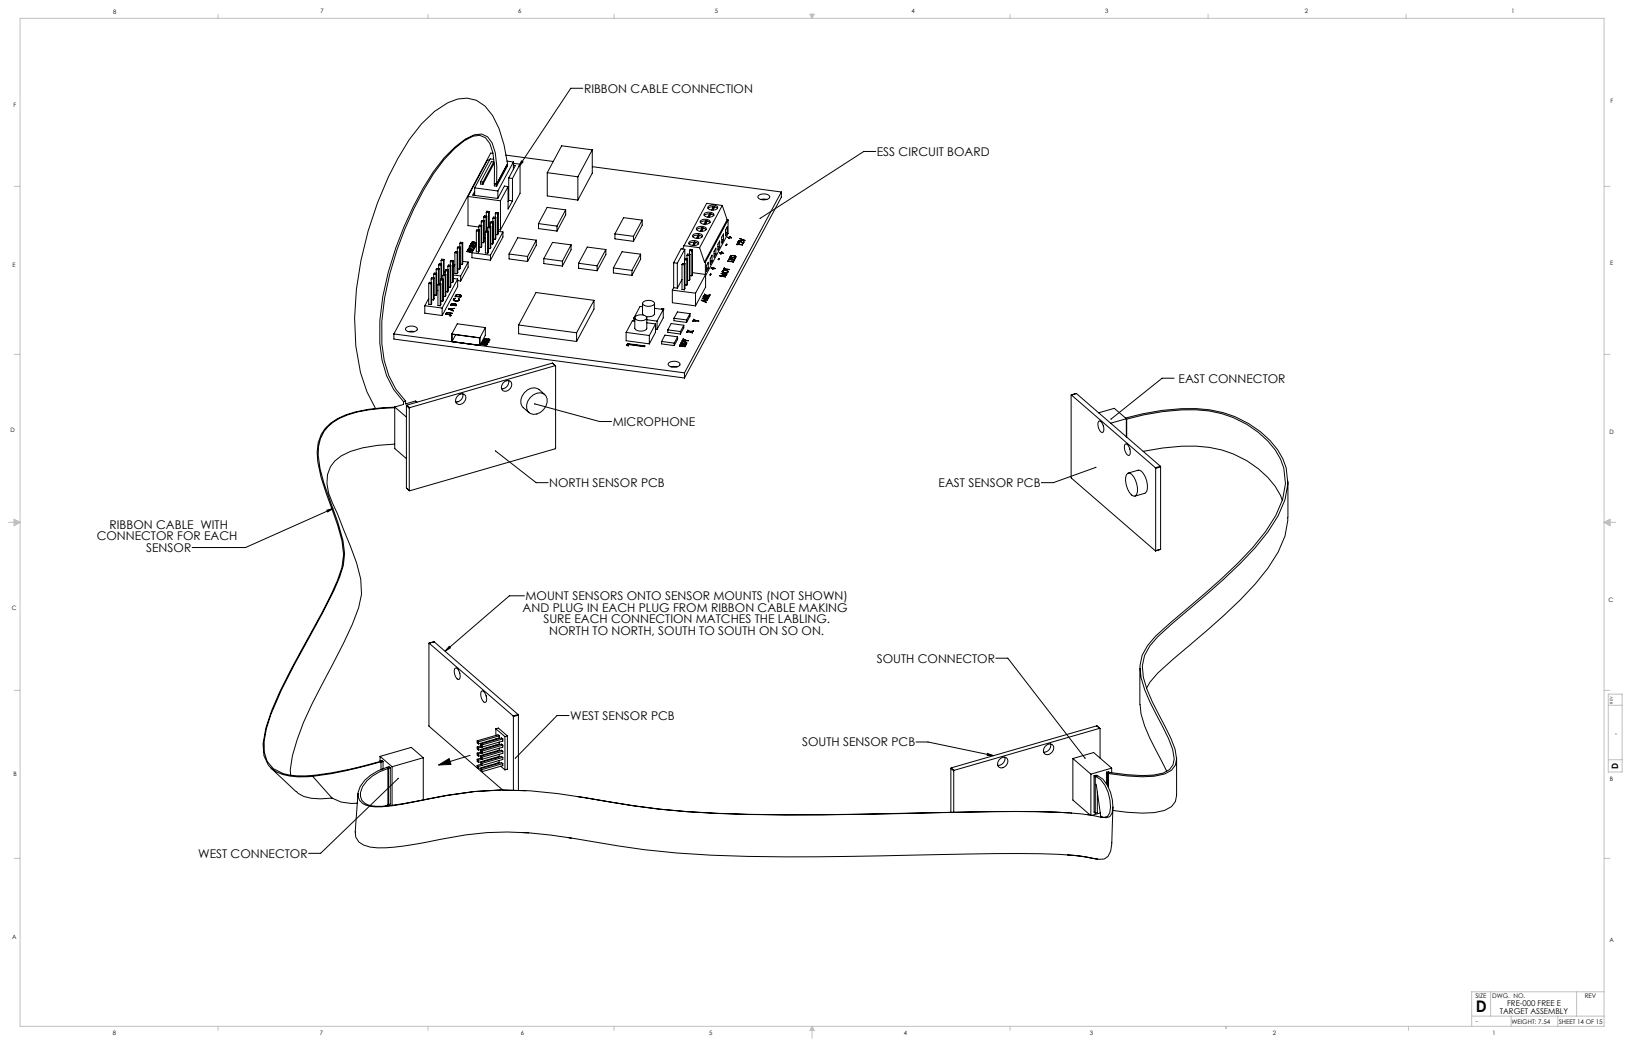
[picture p215: page 14]
WEST CONNECTOR; EAST CONNECTOR; SOUTH CONNECTOR

RIBBON CABLE CONNECTION

ESS CIRCUIT BOARD

NORTH SENSOR PCB

EAST SENSOR PCB

RIBBON CABLE WITH
CONNECTOR FOR EACH

MOUNT SENSORS ONTO SENSOR MOUNTS (NOT SHOWN)
AND PLUG IN EACH PLUG FROM RIBBON CABLE MAKING
SURE EACH CONNECTION MATCHES THE LABLING.
NORTH TO NORTH, SOUTH TO SOUTH ON SO ON.

WEST SENSOR PCB

SOUTH SENSOR PCB

- WEIGHT: 7.54 SHEET 14 OF 15

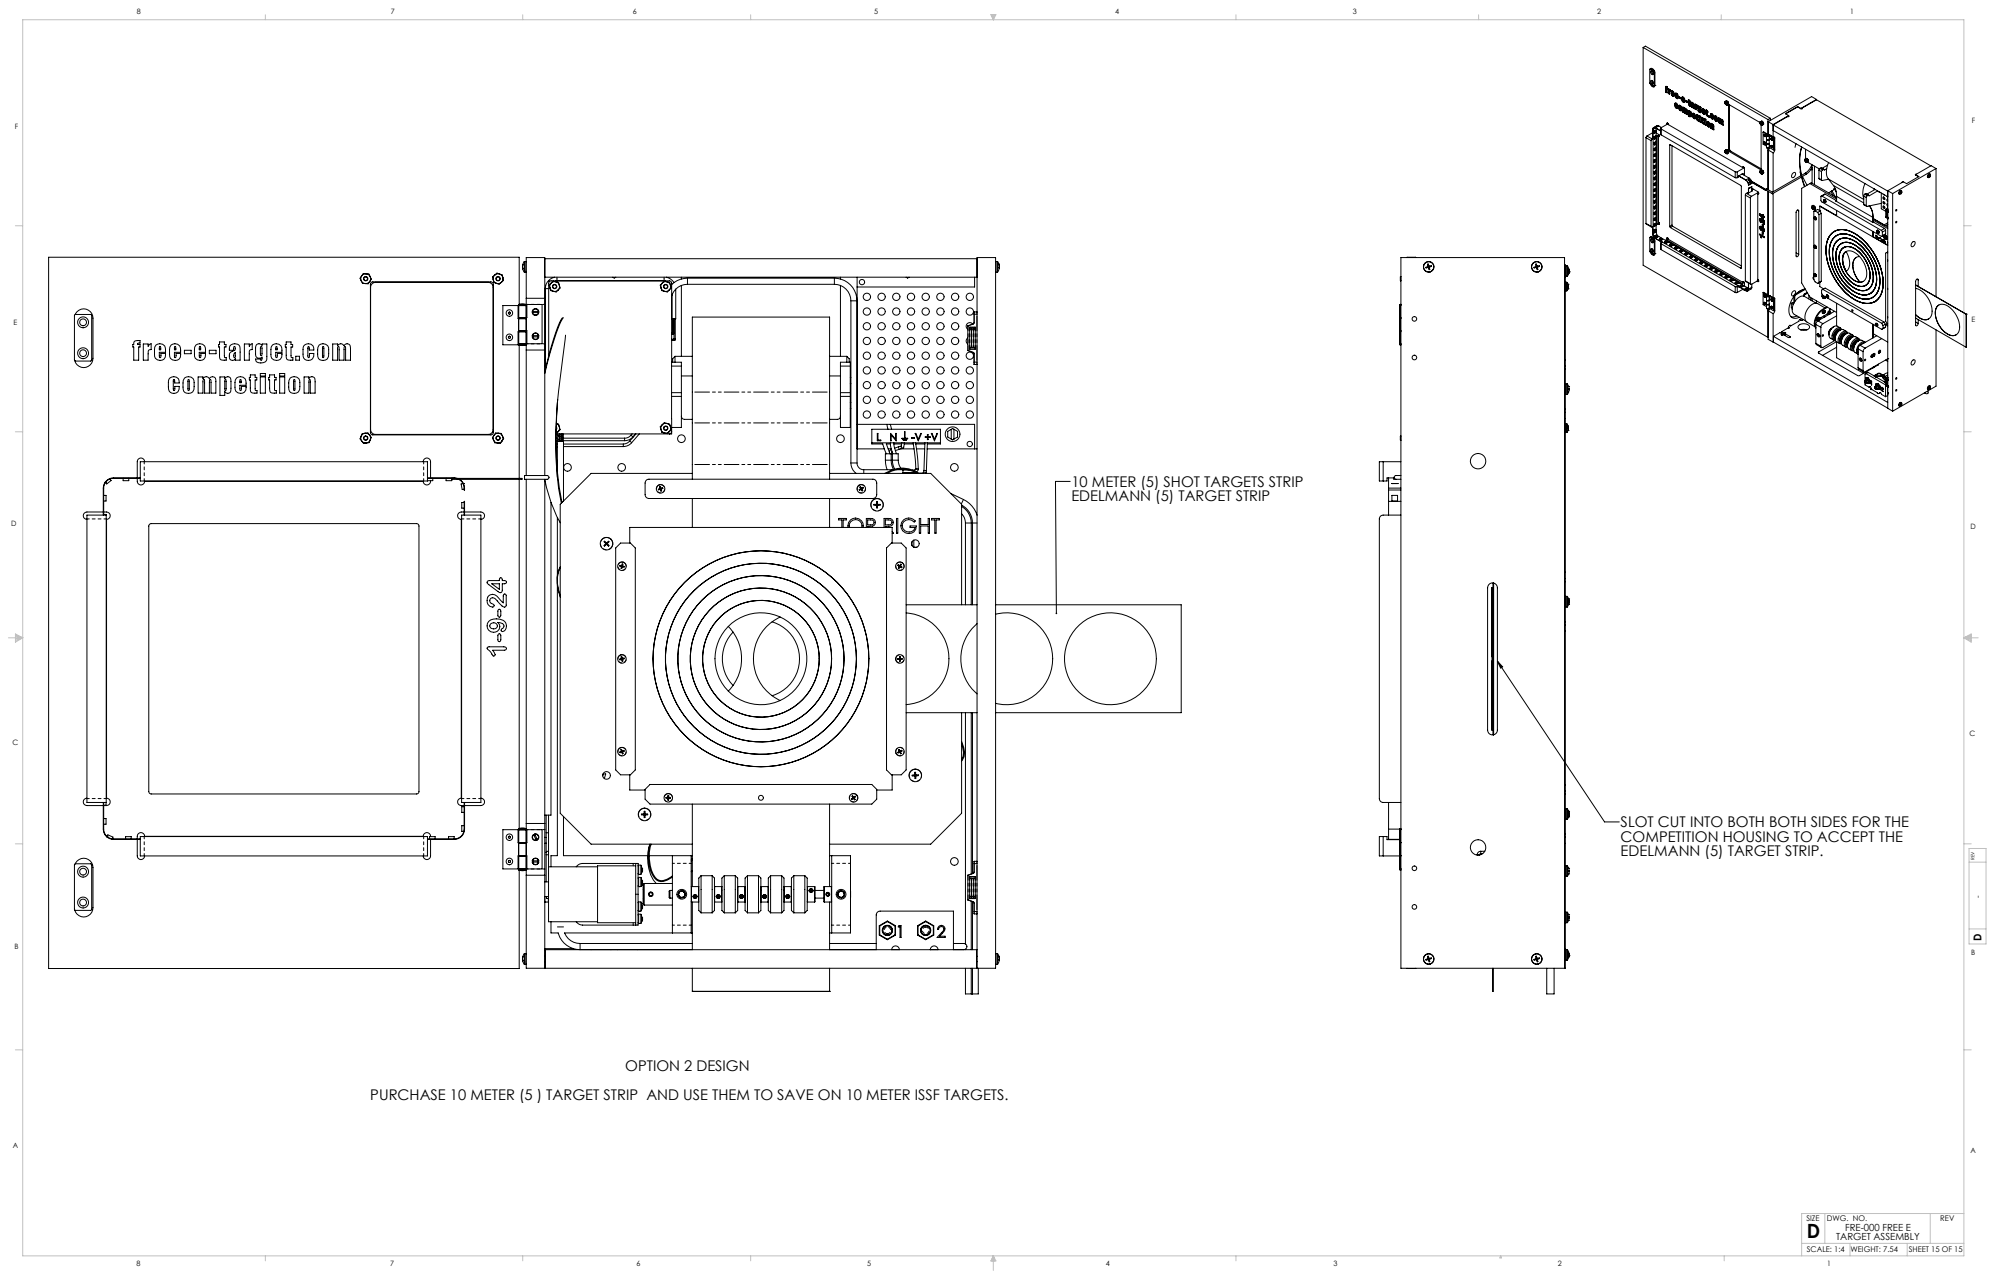
[picture p216: page 15]
OPTION 2 DESIGN

10 METER (5) SHOT TARGETS STRIP
EDELMANN (5) TARGET STRIP

SLOT CUT INTO BOTH BOTH SIDES FOR THE
COMPETITION HOUSING TO ACCEPT THE
EDELMANN (5) TARGET STRIP.

PURCHASE 10 METER (5 ) TARGET STRIP AND USE THEM TO SAVE ON 10 METER ISSF TARGETS.

SCALE: 1:4 WEIGHT: 7.54 SHEET 15 OF 15
